grzechot/smokepowerlatch/enclosures/README.md

# Enclosures

> **Work in progress.** The enclosures here are draft versions. They will be modified,
> and more enclosures (detector module, front panel, …) will be added.
>
> *Wersje robocze – obudowy będą jeszcze zmieniane, a kolejne zostaną dodane.*

| Folder | What | Status |
|---|---|---|
| [mains_module_v4](mains_module_v4/) | 230 V module: relays K1, K2 and the 5 V standby PSU, screwed to the side of an existing printer power-switch / SSR enclosure | draft v4 (261103), not yet printed and tested |
