grzechot/smokepowerlatch/enclosures/mains_module_v4/modul_korpus.step

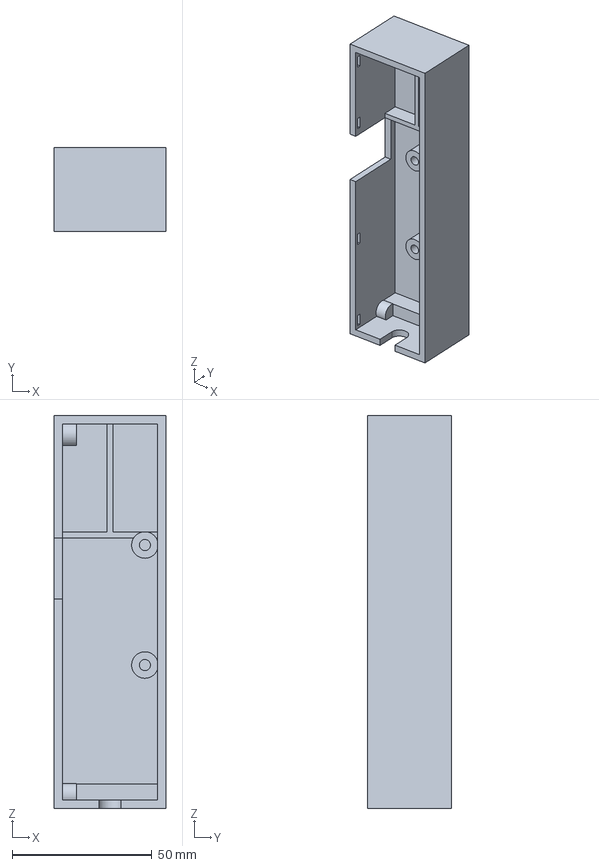
[picture p2: CAD file, 2026-11-06]
enclosures/mains_module_v4/modul_korpus.step
40.0 x 30.0 x 140.8 mm
