grzechot/smokepowerlatch/enclosures/mains_module_v4/modul_pokrywa.step

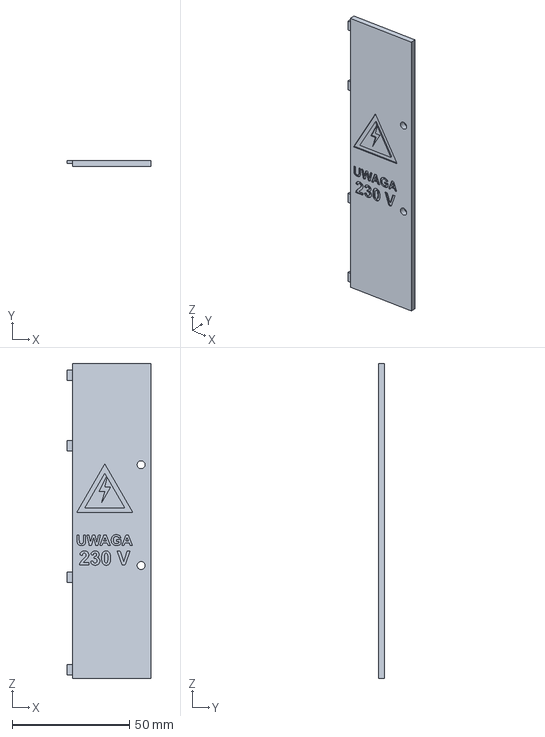
[picture p3: CAD file, 2026-11-06]
enclosures/mains_module_v4/modul_pokrywa.step
36.0 x 2.60 x 134.4 mm
