grzechot/smokepowerlatch/(list of files, cad)

Other CAD files:
enclosures/mains_module_v4/body_print.stl
enclosures/mains_module_v4/cap_print.stl
