grzechot/smokepowerlatch/kicad/printer_power_safety.kicad_sch

## KiCad design kicad/printer_power_safety.kicad_sch (2026-11-05)

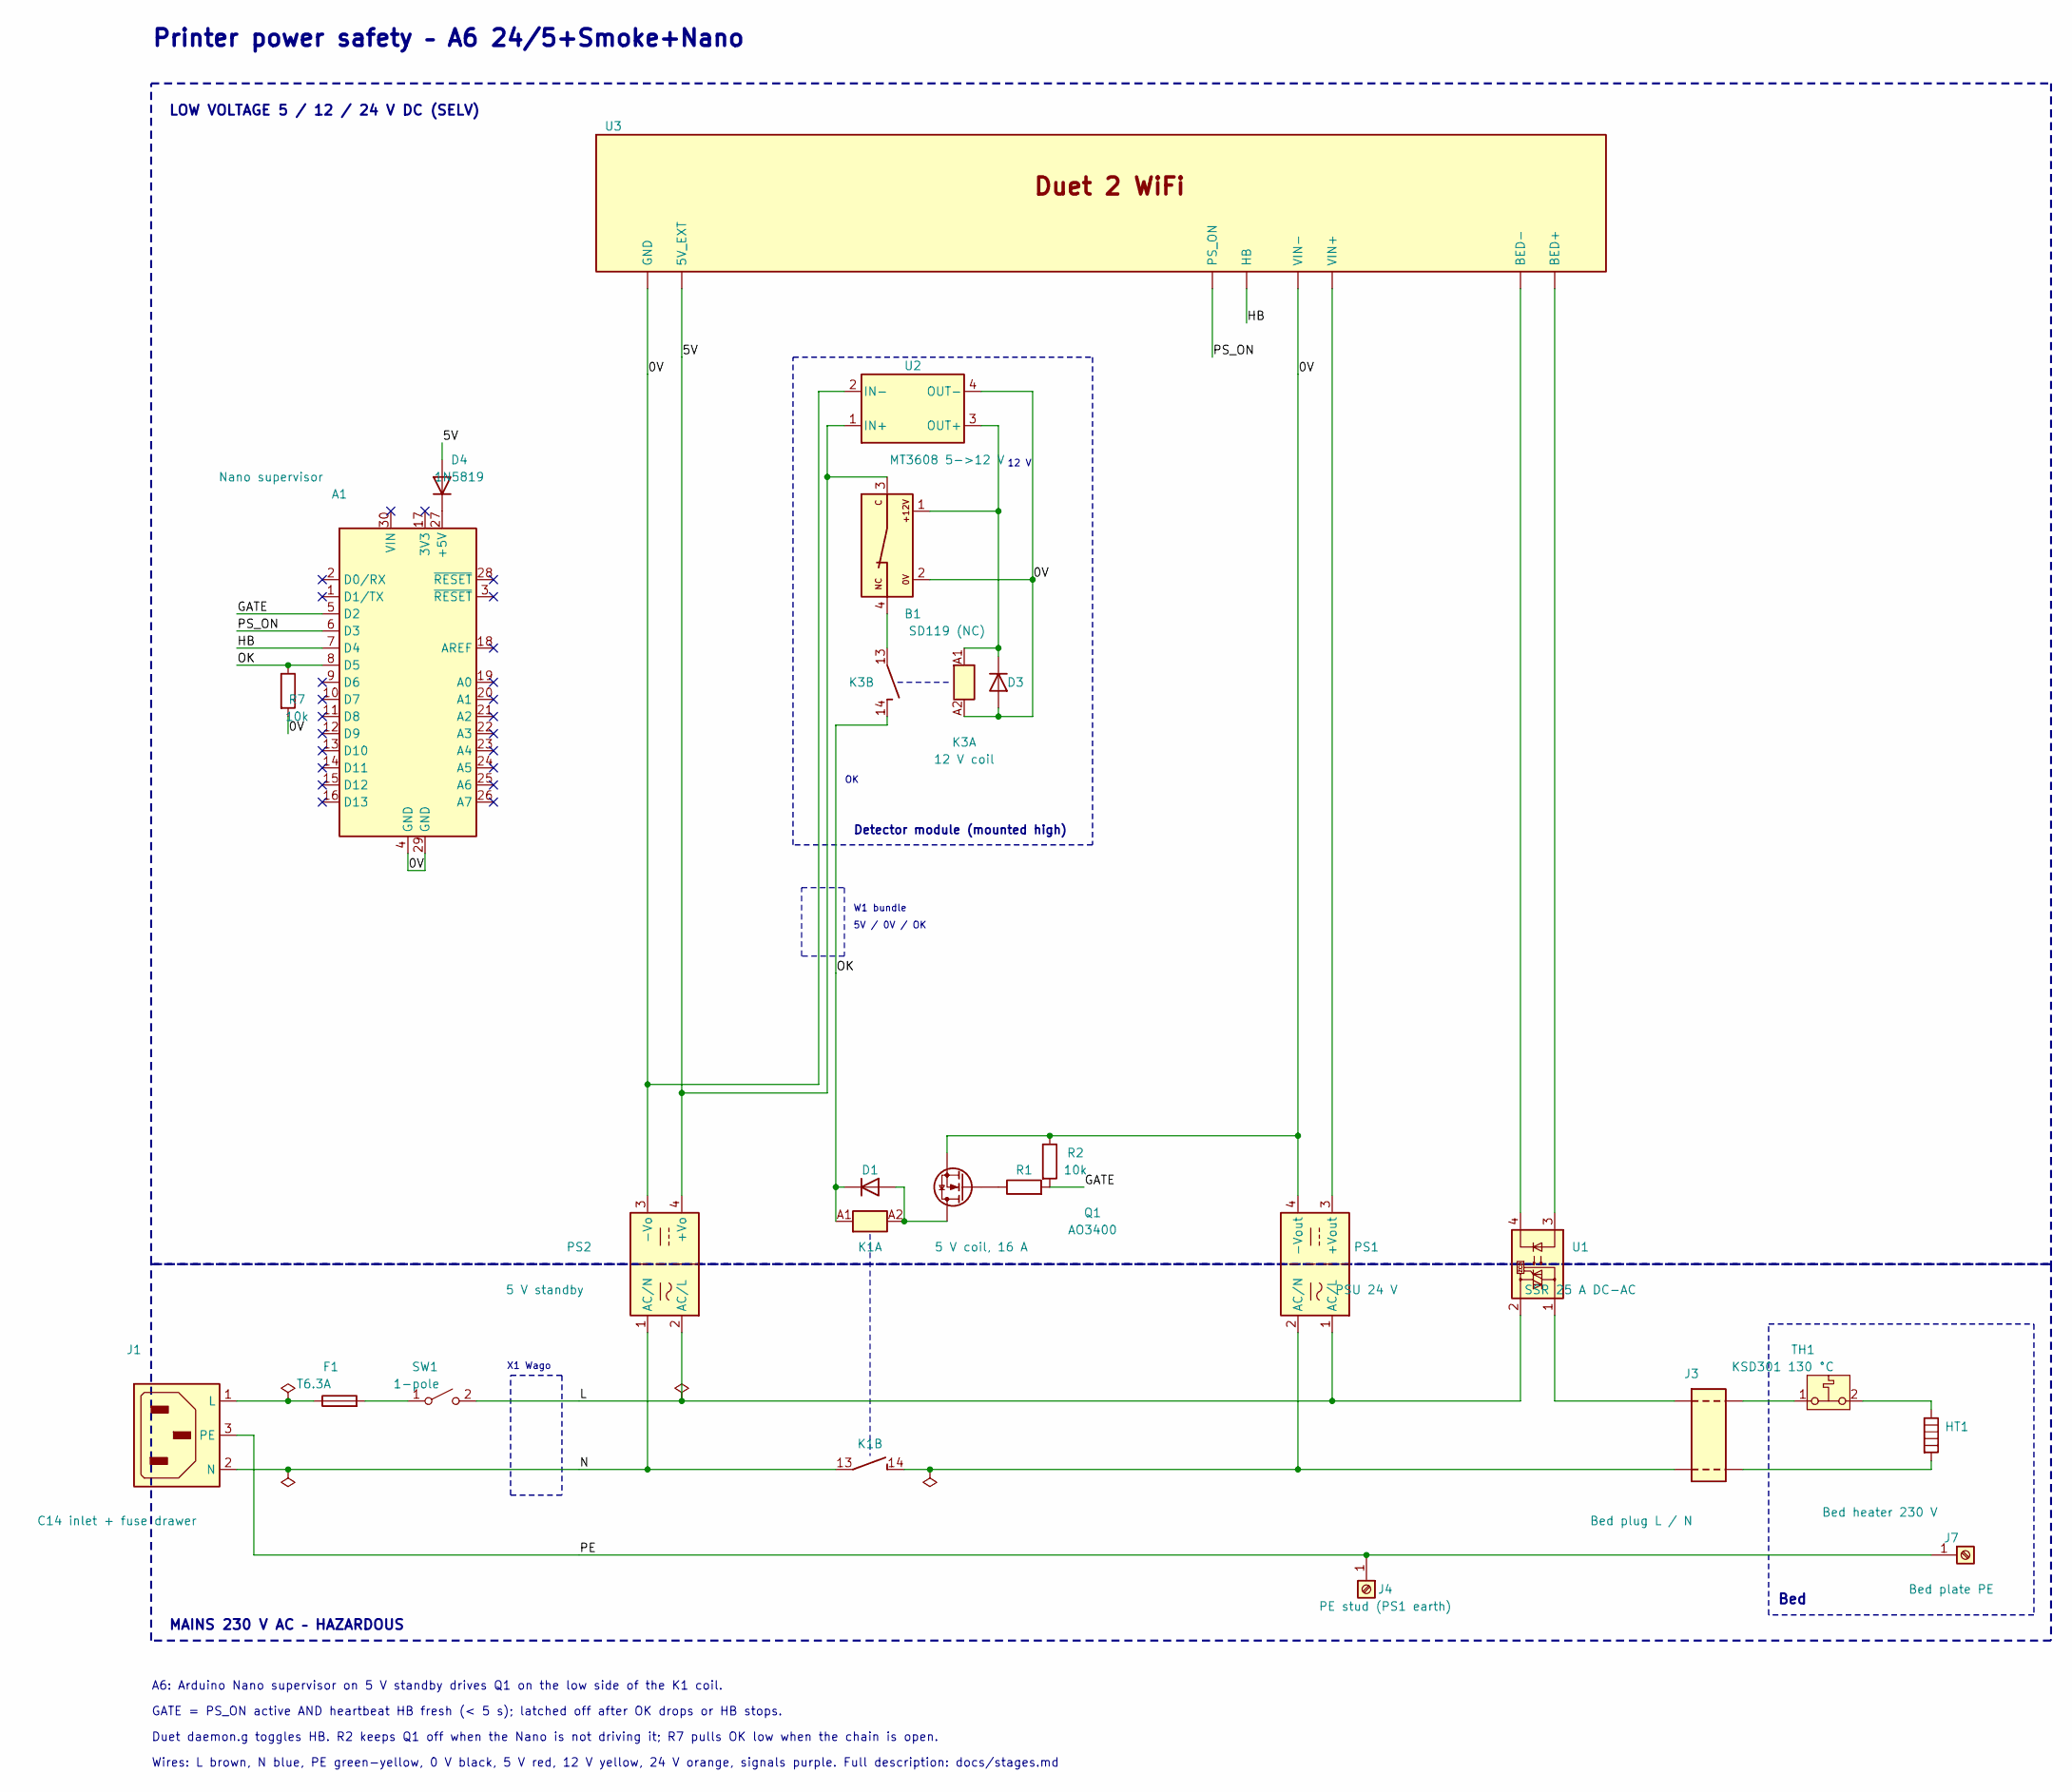
[picture p11: schematic printer_power_safety.kicad_sch]

Parts:
A1: Nano supervisor
B1: SD119 (NC)
D1, D3: 1N4148
D4: 1N5819
F1: T6.3A
HT1: Bed heater 230 V
J1: C14 inlet + fuse drawer
J3: Bed plug L / N
J4: PE stud (PS1 earth)
J7: Bed plate PE
K1, K3: (no value)
PS1: PSU 24 V
PS2: 5 V standby
Q1: AO3400
R1: 100
R2, R7: 10k
SW1: 1-pole
TH1: KSD301 130 °C
U1: SSR 25 A DC-AC
U2: MT3608 5->12 V
U3: Duet 2 WiFi

Connections:
0V: A1.4 (GND), A1.29 (GND), B1.2 (0V), D3.2 (A), K3.A2, PS1.4 (-Vout), PS2.3 (-Vo), Q1.S, R2.1, R7.2, U2.2 (IN-), U2.4 (OUT-), U3.1 (GND), U3.5 (VIN-)
5V: B1.3 (C), D4.2 (A), PS2.4 (+Vo), U2.1 (IN+), U3.2 (5V_EXT)
GATE: A1.5 (D2), R1.2, R2.2
HB: A1.7 (D4), U3.4 (HB)
L: PS1.1 (AC/L), PS2.2 (AC/L), SW1.2 (B), U1.2
N: J1.2 (N), K1.13, PS2.1 (AC/N)
unnamed: A1.27 (+5V), D4.1 (K)
unnamed: B1.1 (+12V), D3.1 (K), K3.A1, U2.3 (OUT+)
unnamed: B1.4 (NC), K3.13
unnamed: D1.2 (A), K1.A2, Q1.D
unnamed: F1.1, J1.1 (L)
unnamed: F1.2, SW1.1 (A)
unnamed: HT1.1, TH1.2
unnamed: HT1.2, J3.4 (N)
unnamed: J3.1 (L), U1.1
unnamed: J3.2 (N), K1.14, PS1.2 (AC/N)
unnamed: J3.3 (L), TH1.1
unnamed: PS1.3 (+Vout), U3.6 (VIN+)
unnamed: Q1.G, R1.1
unnamed: U1.3, U3.8 (BED+)
unnamed: U1.4, U3.7 (BED-)
OK: A1.8 (D5), D1.1 (K), K1.A1, K3.14, R7.1
PE: J1.3 (PE), J4.1, J7.1
PS_ON: A1.6 (D3), U3.3 (PS_ON)

Notes on the sheet:
X1 Wago
Bed
Detector module (mounted high)
W1 bundle
5V / 0V / OK
12 V
LOW VOLTAGE 5 / 12 / 24 V DC (SELV)
MAINS 230 V AC – HAZARDOUS
Printer power safety – A6 24/5+Smoke+Nano
A6: Arduino Nano supervisor on 5 V standby drives Q1 on the low side of the K1 coil.
GATE = PS_ON active AND heartbeat HB fresh (< 5 s); latched off after OK drops or HB stops.
Duet daemon.g toggles HB. R2 keeps Q1 off when the Nano is not driving it; R7 pulls OK low when the chain is open.
Wires: L brown, N blue, PE green-yellow, 0 V black, 5 V red, 12 V yellow, 24 V orange, signals purple. Full description: docs/stages.md
