grzechot/smokepowerlatch/kicad/steps/A0_firestarter.kicad_sch

## KiCad design kicad/steps/A0_firestarter.kicad_sch (2026-11-05)

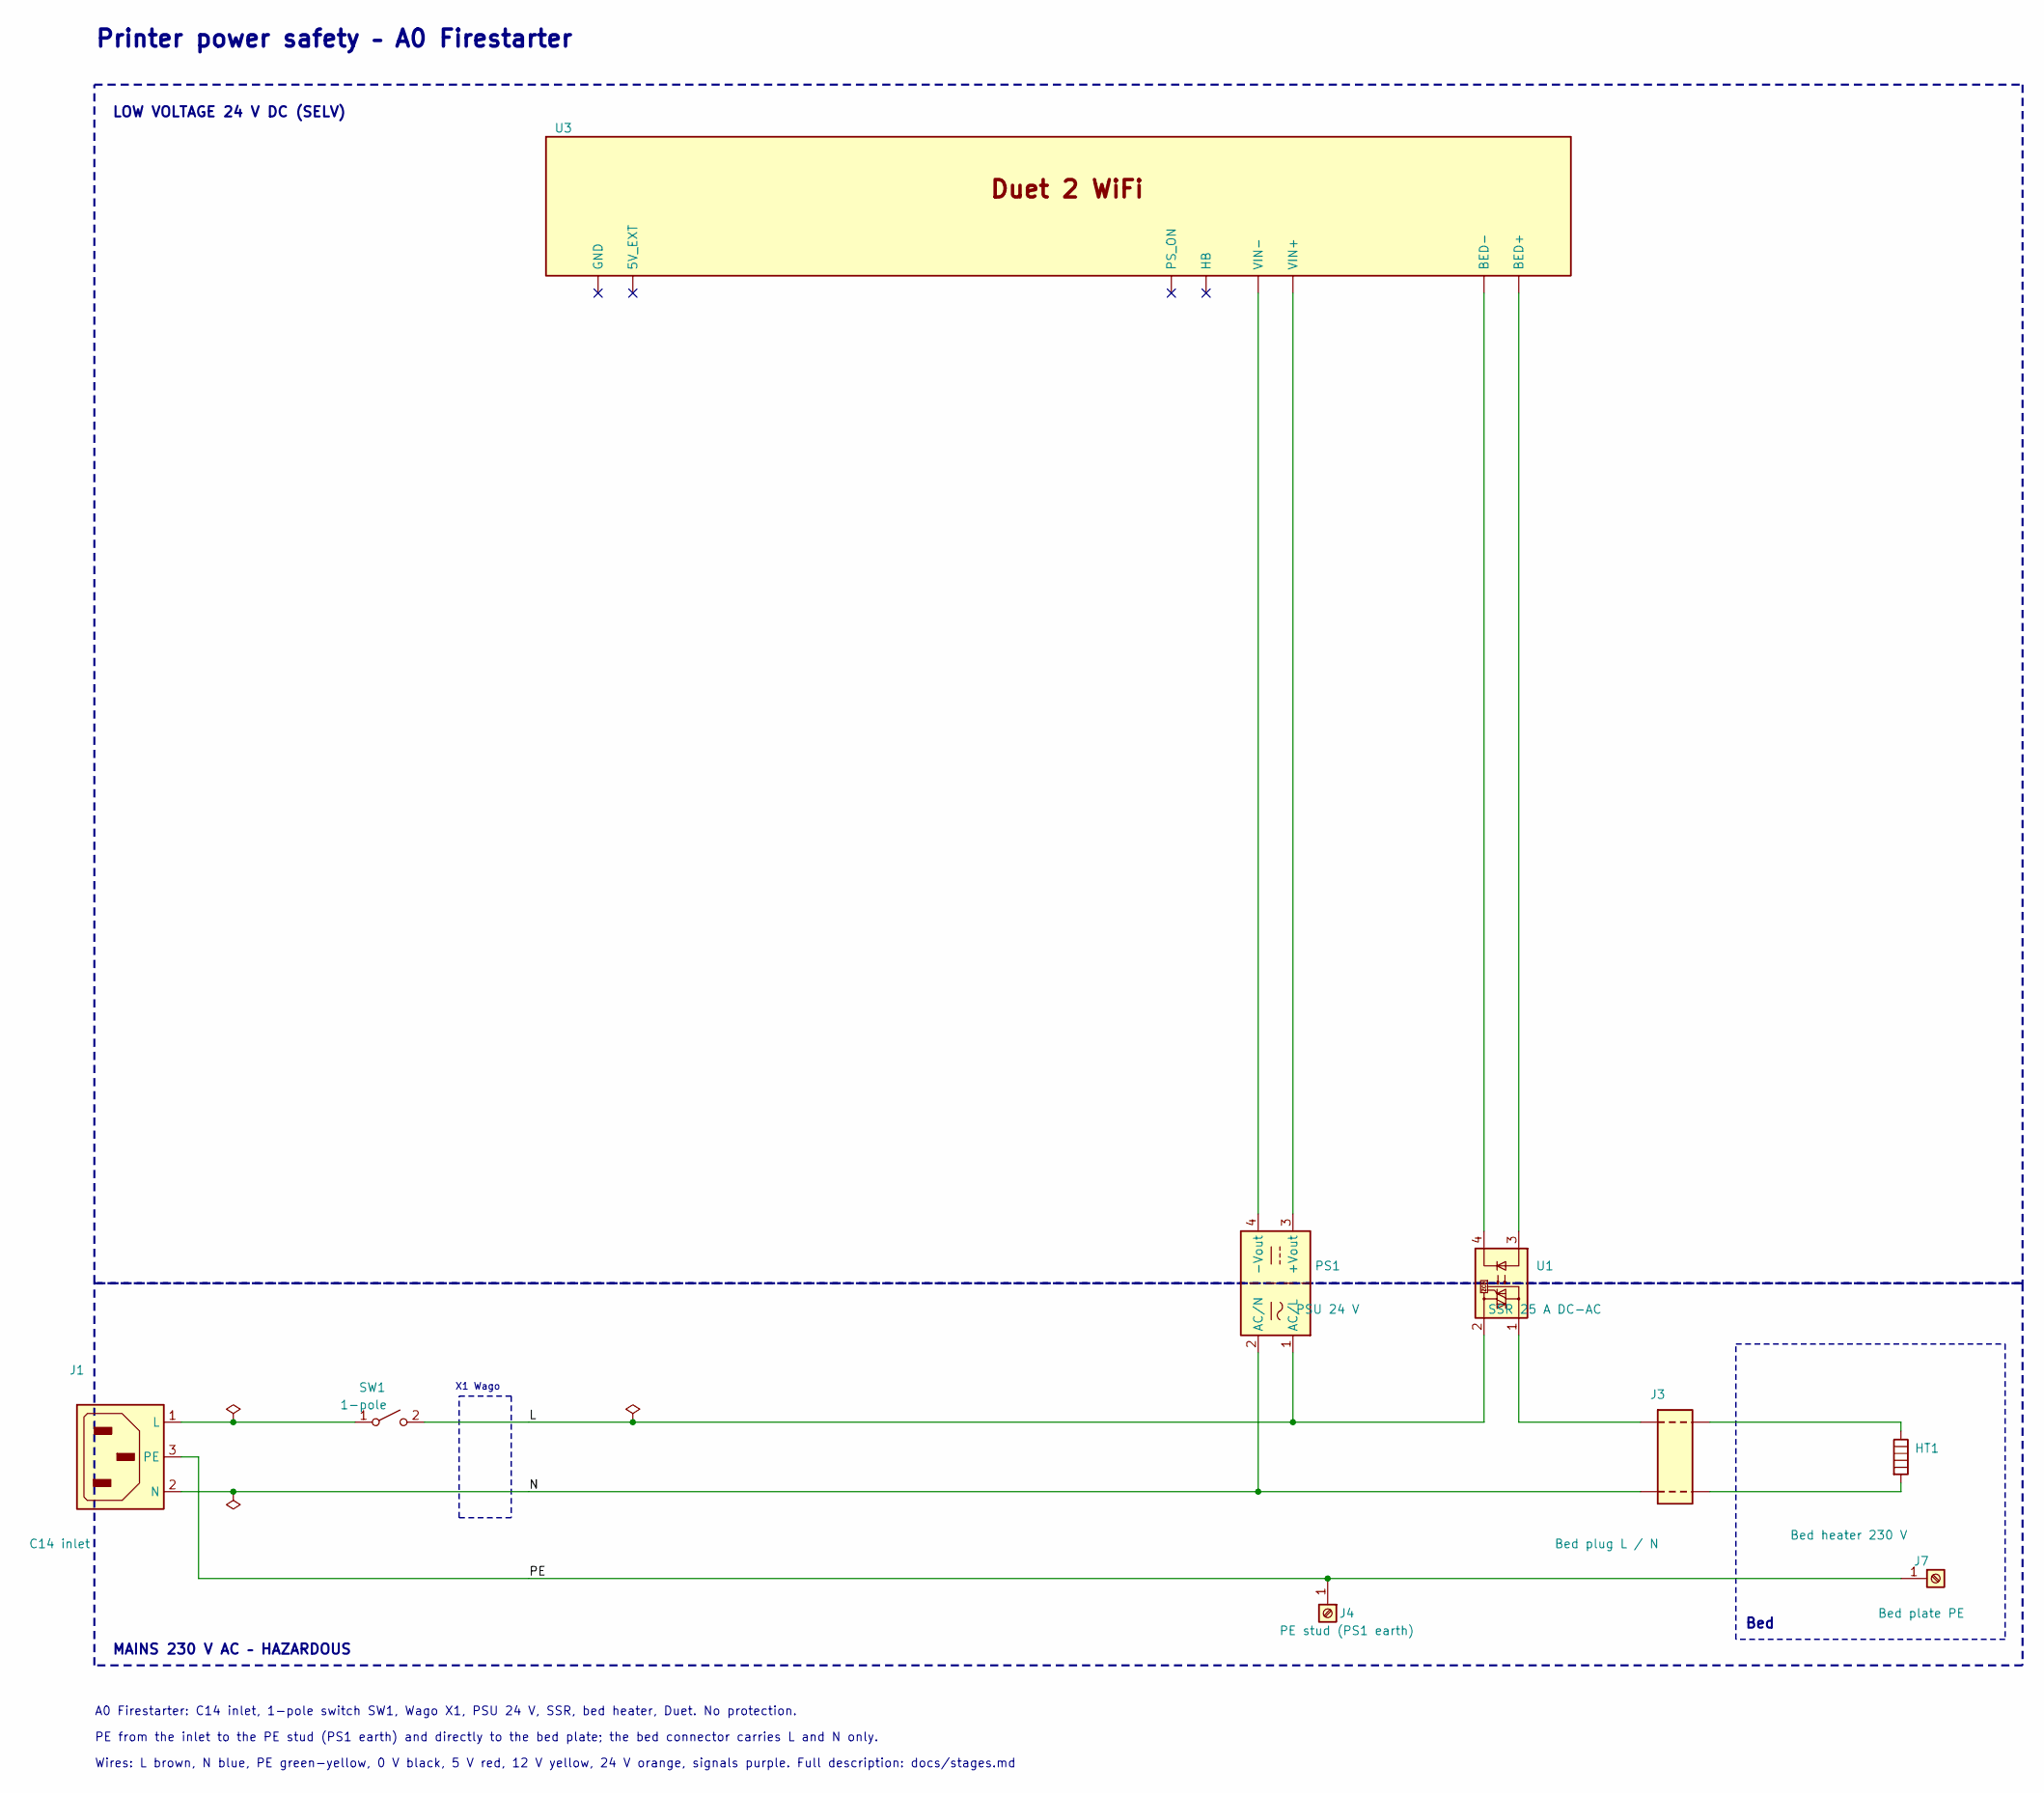
[picture p12: schematic A0_firestarter.kicad_sch]

Parts:
HT1: Bed heater 230 V
J1: C14 inlet
J3: Bed plug L / N
J4: PE stud (PS1 earth)
J7: Bed plate PE
PS1: PSU 24 V
SW1: 1-pole
U1: SSR 25 A DC-AC
U3: Duet 2 WiFi

Connections:
L: PS1.1 (AC/L), SW1.2 (B), U1.2
N: J1.2 (N), J3.2 (N), PS1.2 (AC/N)
unnamed: HT1.1, J3.3 (L)
unnamed: HT1.2, J3.4 (N)
unnamed: J1.1 (L), SW1.1 (A)
unnamed: J3.1 (L), U1.1
unnamed: PS1.3 (+Vout), U3.6 (VIN+)
unnamed: PS1.4 (-Vout), U3.5 (VIN-)
unnamed: U1.3, U3.8 (BED+)
unnamed: U1.4, U3.7 (BED-)
PE: J1.3 (PE), J4.1, J7.1

Notes on the sheet:
X1 Wago
Bed
LOW VOLTAGE 24 V DC (SELV)
MAINS 230 V AC – HAZARDOUS
Printer power safety – A0 Firestarter
A0 Firestarter: C14 inlet, 1-pole switch SW1, Wago X1, PSU 24 V, SSR, bed heater, Duet. No protection.
PE from the inlet to the PE stud (PS1 earth) and directly to the bed plate; the bed connector carries L and N only.
Wires: L brown, N blue, PE green-yellow, 0 V black, 5 V red, 12 V yellow, 24 V orange, signals purple. Full description: docs/stages.md
