grzechot/smokepowerlatch/kicad/steps/A2_24_thermalcut_fuse.kicad_sch

## KiCad design kicad/steps/A2_24_thermalcut_fuse.kicad_sch (2026-11-05)

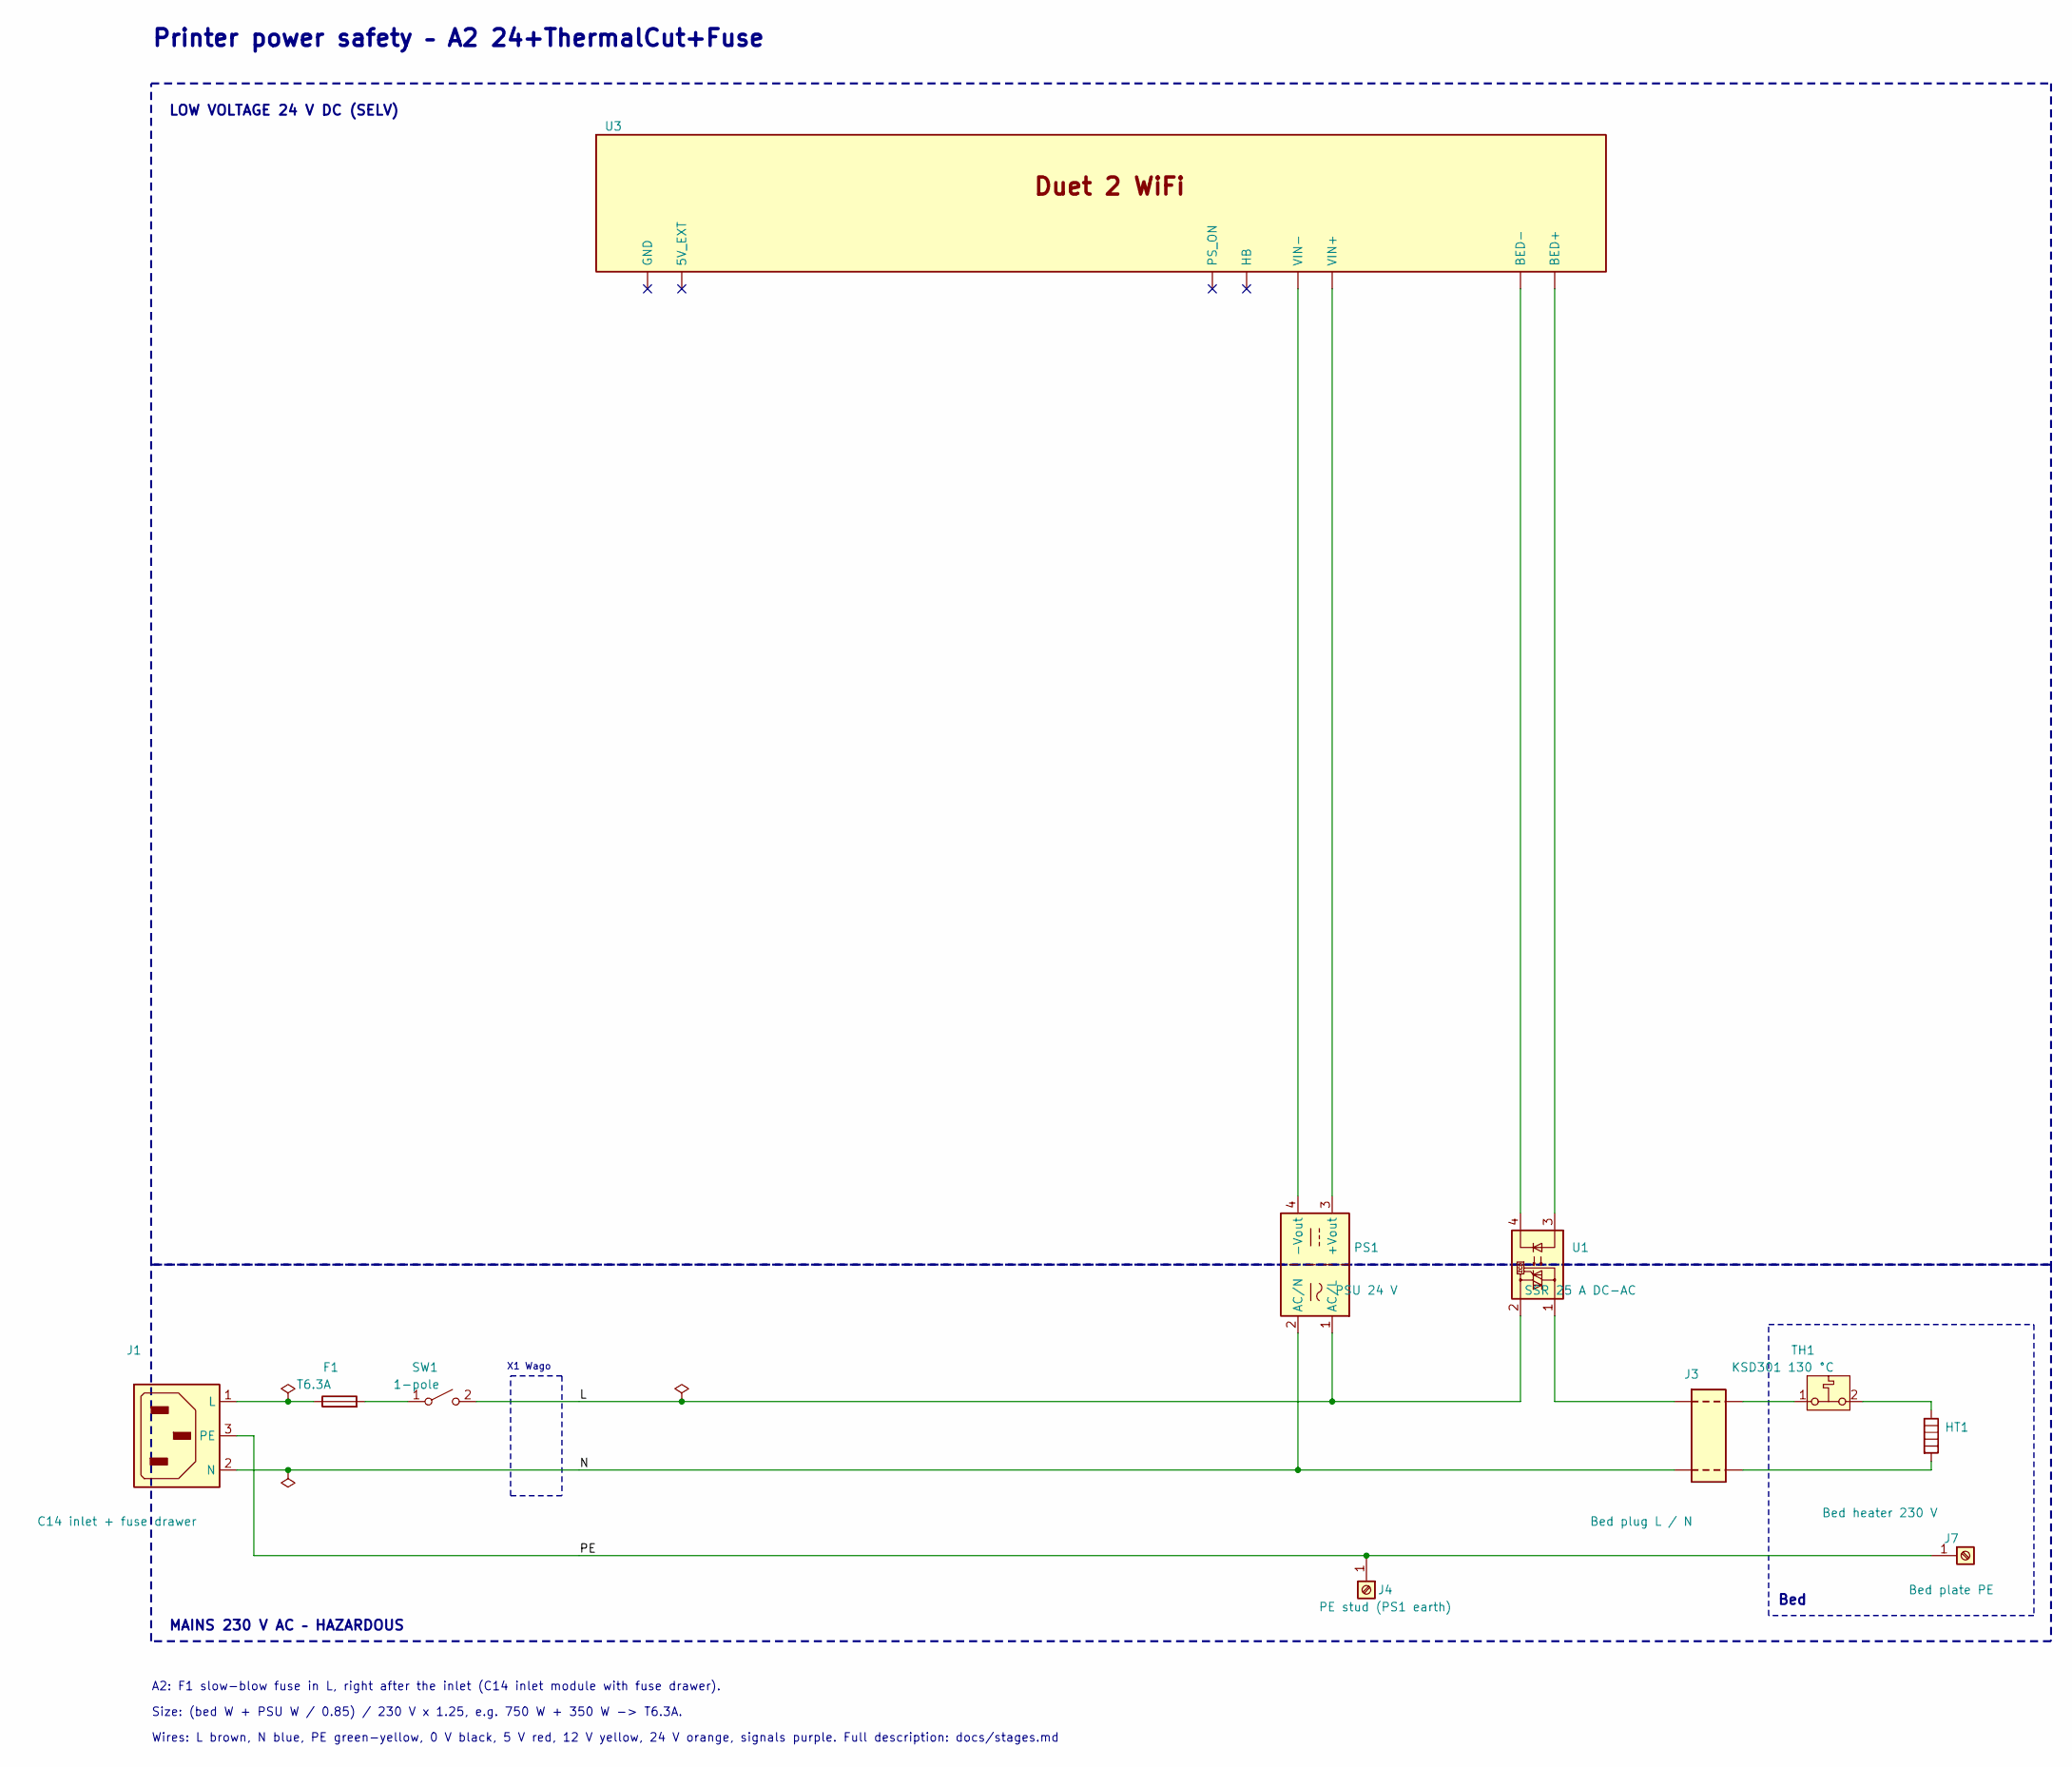
[picture p13: schematic A2_24_thermalcut_fuse.kicad_sch]

Parts:
F1: T6.3A
HT1: Bed heater 230 V
J1: C14 inlet + fuse drawer
J3: Bed plug L / N
J4: PE stud (PS1 earth)
J7: Bed plate PE
PS1: PSU 24 V
SW1: 1-pole
TH1: KSD301 130 °C
U1: SSR 25 A DC-AC
U3: Duet 2 WiFi

Connections:
L: PS1.1 (AC/L), SW1.2 (B), U1.2
N: J1.2 (N), J3.2 (N), PS1.2 (AC/N)
unnamed: F1.1, J1.1 (L)
unnamed: F1.2, SW1.1 (A)
unnamed: HT1.1, TH1.2
unnamed: HT1.2, J3.4 (N)
unnamed: J3.1 (L), U1.1
unnamed: J3.3 (L), TH1.1
unnamed: PS1.3 (+Vout), U3.6 (VIN+)
unnamed: PS1.4 (-Vout), U3.5 (VIN-)
unnamed: U1.3, U3.8 (BED+)
unnamed: U1.4, U3.7 (BED-)
PE: J1.3 (PE), J4.1, J7.1

Notes on the sheet:
X1 Wago
Bed
LOW VOLTAGE 24 V DC (SELV)
MAINS 230 V AC – HAZARDOUS
Printer power safety – A2 24+ThermalCut+Fuse
A2: F1 slow-blow fuse in L, right after the inlet (C14 inlet module with fuse drawer).
Size: (bed W + PSU W / 0.85) / 230 V x 1.25, e.g. 750 W + 350 W -> T6.3A.
Wires: L brown, N blue, PE green-yellow, 0 V black, 5 V red, 12 V yellow, 24 V orange, signals purple. Full description: docs/stages.md
