grzechot/smokepowerlatch/kicad/steps/A3_24_relay.kicad_sch

## KiCad design kicad/steps/A3_24_relay.kicad_sch (2026-11-05)

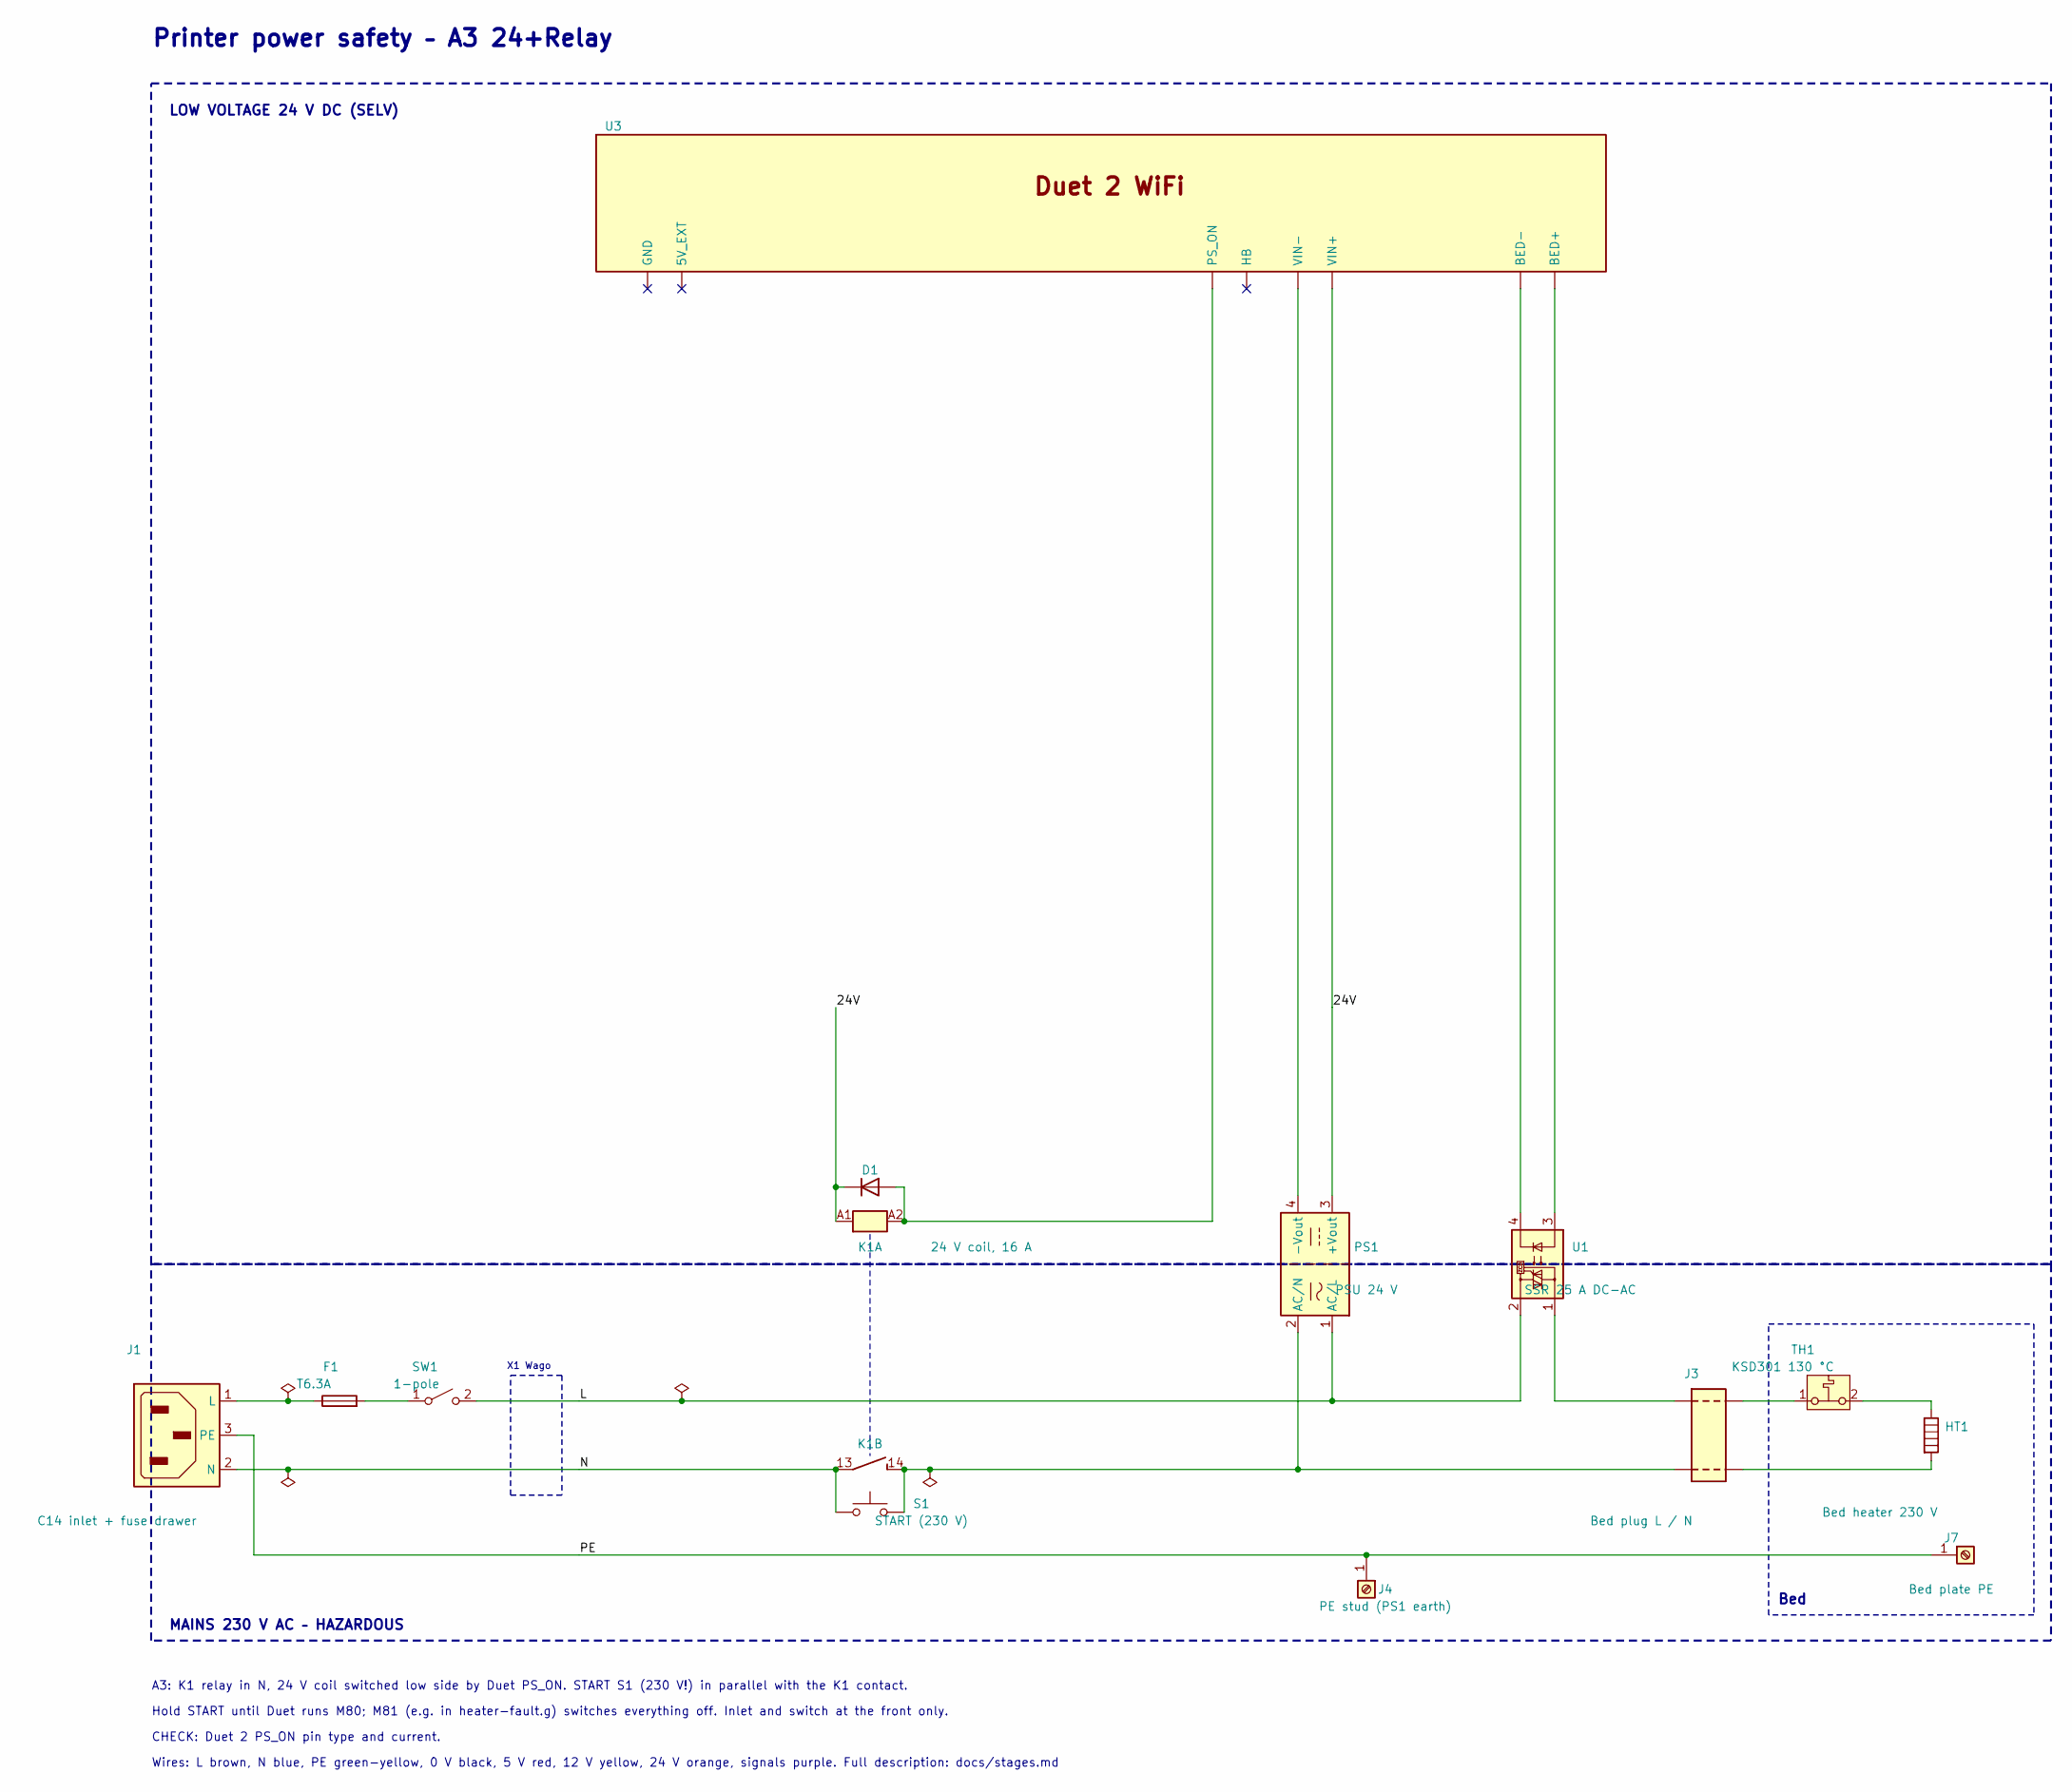
[picture p14: schematic A3_24_relay.kicad_sch]

Parts:
D1: 1N4148
F1: T6.3A
HT1: Bed heater 230 V
J1: C14 inlet + fuse drawer
J3: Bed plug L / N
J4: PE stud (PS1 earth)
J7: Bed plate PE
K1: (no value)
PS1: PSU 24 V
S1: START (230 V)
SW1: 1-pole
TH1: KSD301 130 °C
U1: SSR 25 A DC-AC
U3: Duet 2 WiFi

Connections:
24V: D1.1 (K), K1.A1, PS1.3 (+Vout), U3.6 (VIN+)
L: PS1.1 (AC/L), SW1.2 (B), U1.2
N: J1.2 (N), K1.13, S1.1
unnamed: D1.2 (A), K1.A2, U3.3 (PS_ON)
unnamed: F1.1, J1.1 (L)
unnamed: F1.2, SW1.1 (A)
unnamed: HT1.1, TH1.2
unnamed: HT1.2, J3.4 (N)
unnamed: J3.1 (L), U1.1
unnamed: J3.2 (N), K1.14, PS1.2 (AC/N), S1.2
unnamed: J3.3 (L), TH1.1
unnamed: PS1.4 (-Vout), U3.5 (VIN-)
unnamed: U1.3, U3.8 (BED+)
unnamed: U1.4, U3.7 (BED-)
PE: J1.3 (PE), J4.1, J7.1

Notes on the sheet:
X1 Wago
Bed
LOW VOLTAGE 24 V DC (SELV)
MAINS 230 V AC – HAZARDOUS
Printer power safety – A3 24+Relay
A3: K1 relay in N, 24 V coil switched low side by Duet PS_ON. START S1 (230 V!) in parallel with the K1 contact.
Hold START until Duet runs M80; M81 (e.g. in heater-fault.g) switches everything off. Inlet and switch at the front only.
CHECK: Duet 2 PS_ON pin type and current.
Wires: L brown, N blue, PE green-yellow, 0 V black, 5 V red, 12 V yellow, 24 V orange, signals purple. Full description: docs/stages.md
