grzechot/smokepowerlatch/kicad/steps/A5_24-5_smoke.kicad_sch

## KiCad design kicad/steps/A5_24-5_smoke.kicad_sch (2026-11-05)

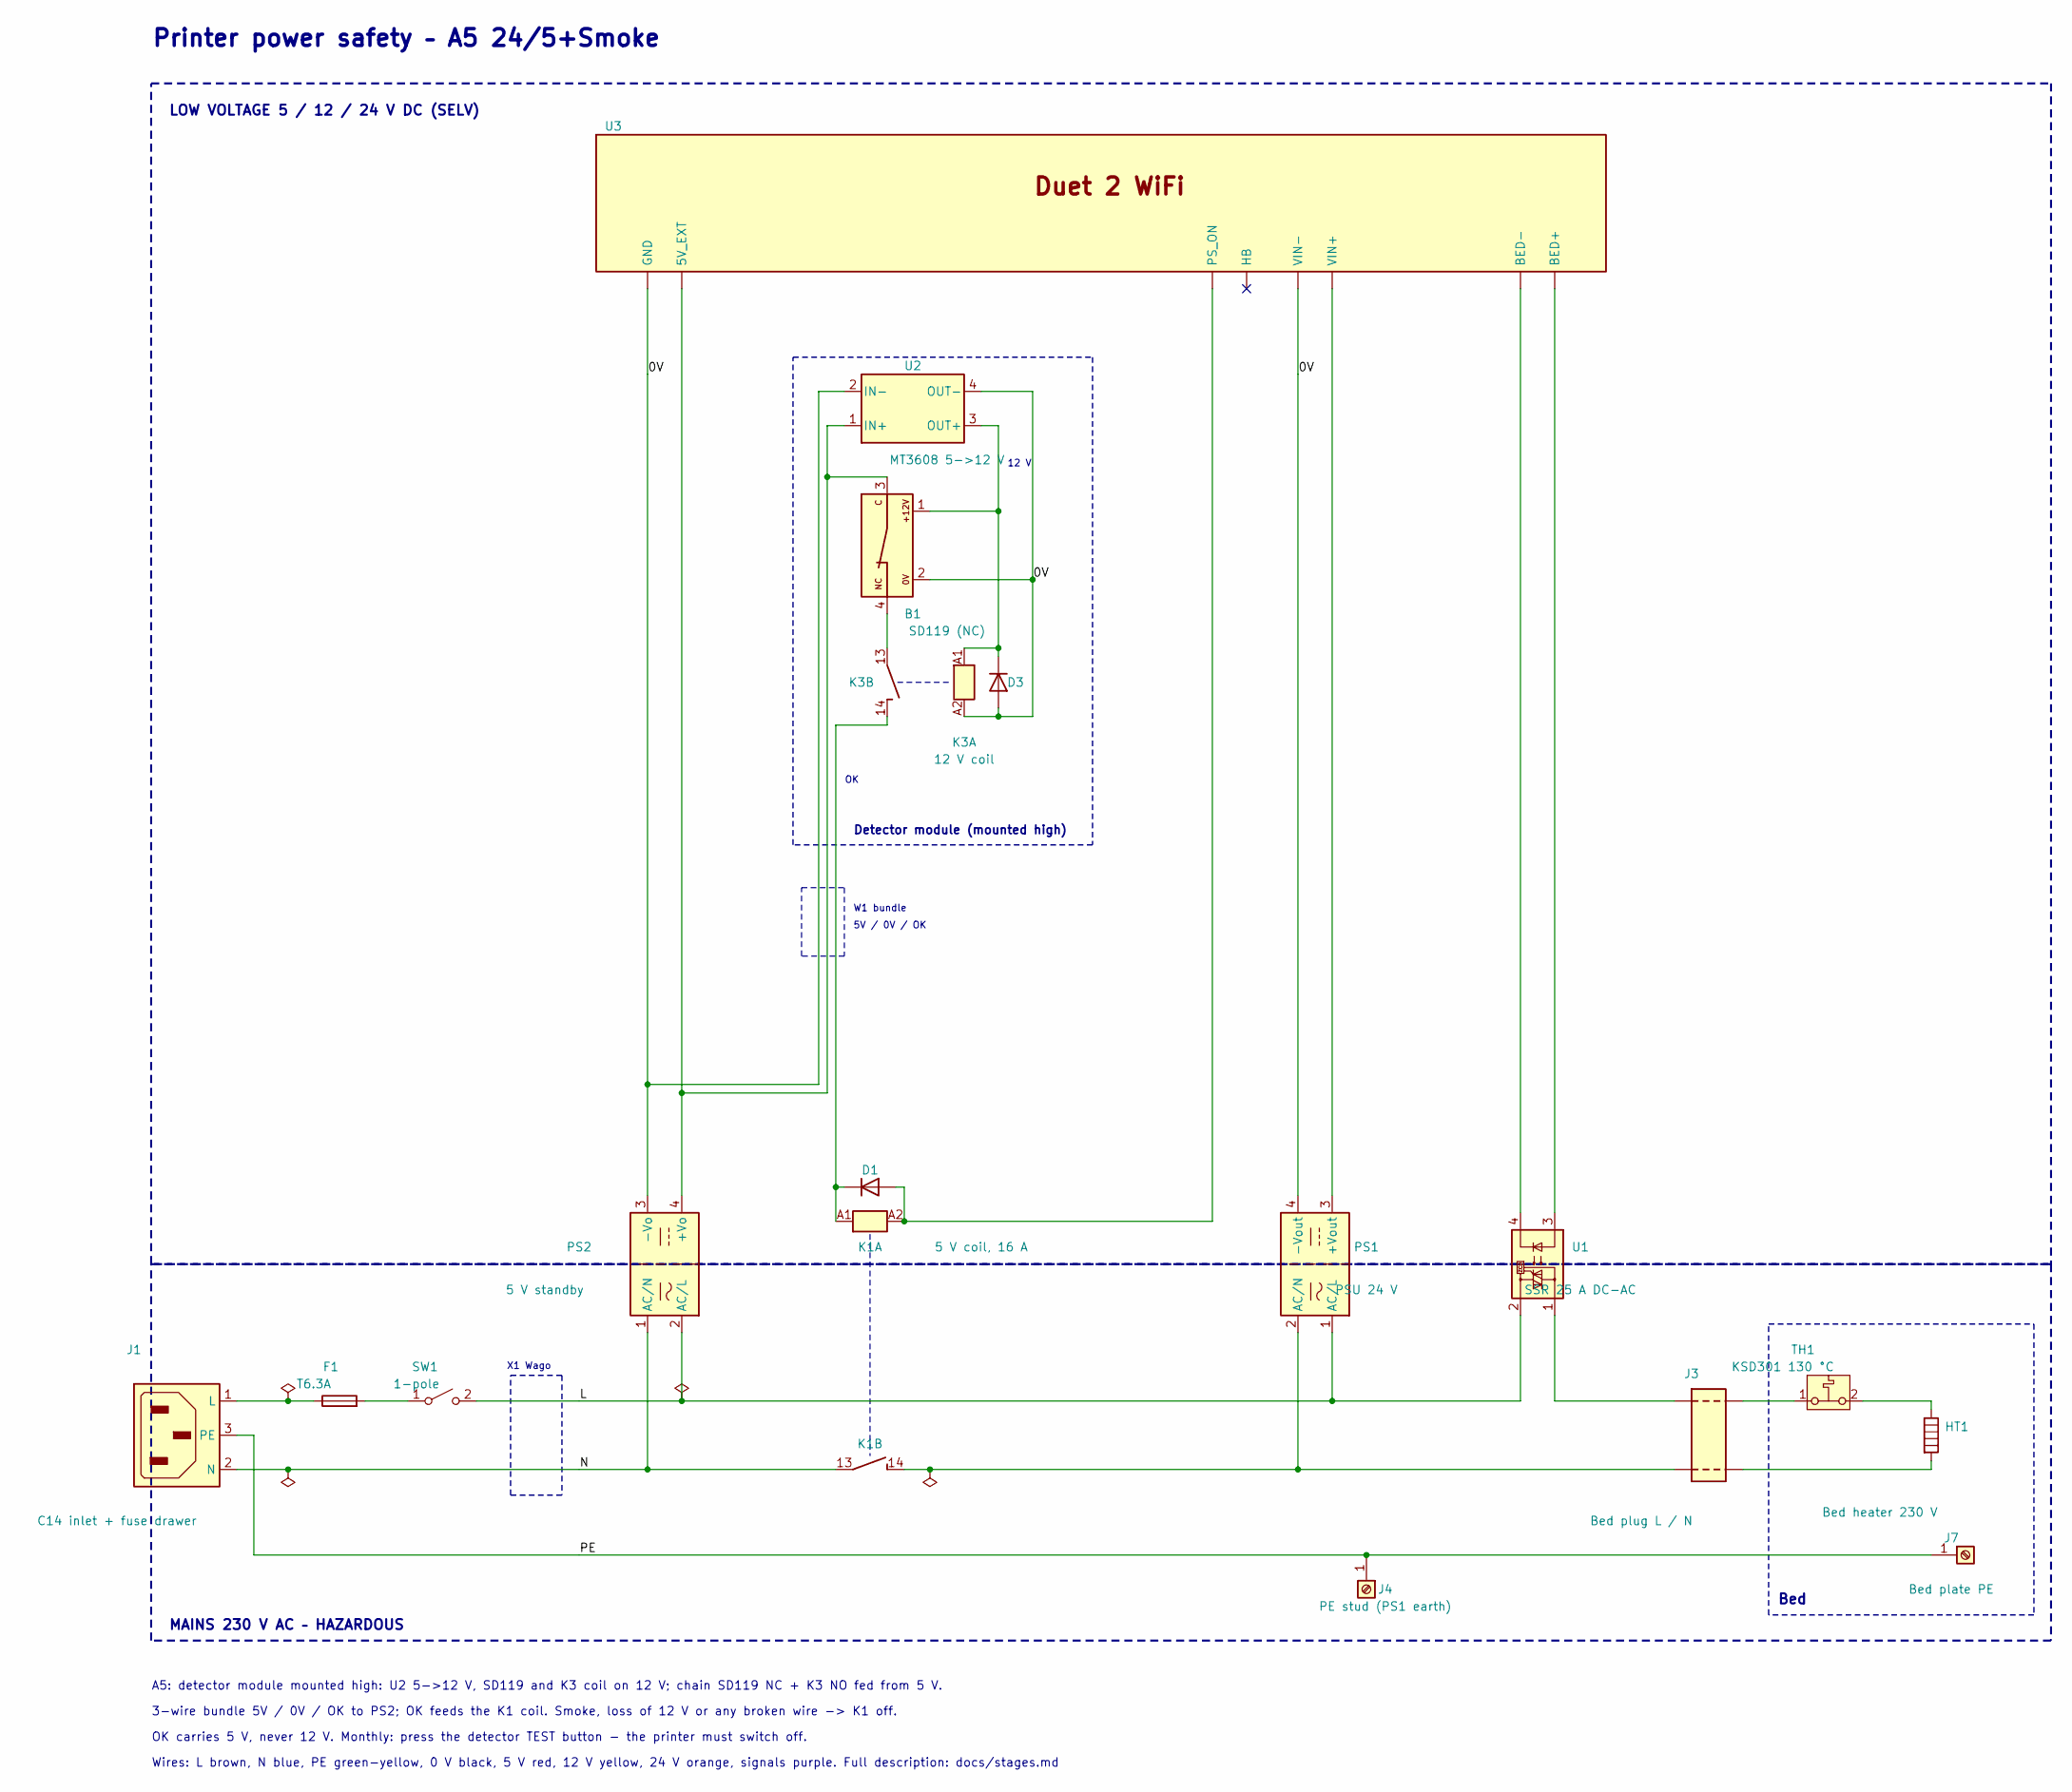
[picture p15: schematic A5_24-5_smoke.kicad_sch]

Parts:
B1: SD119 (NC)
D1, D3: 1N4148
F1: T6.3A
HT1: Bed heater 230 V
J1: C14 inlet + fuse drawer
J3: Bed plug L / N
J4: PE stud (PS1 earth)
J7: Bed plate PE
K1, K3: (no value)
PS1: PSU 24 V
PS2: 5 V standby
SW1: 1-pole
TH1: KSD301 130 °C
U1: SSR 25 A DC-AC
U2: MT3608 5->12 V
U3: Duet 2 WiFi

Connections:
0V: B1.2 (0V), D3.2 (A), K3.A2, PS1.4 (-Vout), PS2.3 (-Vo), U2.2 (IN-), U2.4 (OUT-), U3.1 (GND), U3.5 (VIN-)
L: PS1.1 (AC/L), PS2.2 (AC/L), SW1.2 (B), U1.2
N: J1.2 (N), K1.13, PS2.1 (AC/N)
unnamed: B1.1 (+12V), D3.1 (K), K3.A1, U2.3 (OUT+)
unnamed: B1.3 (C), PS2.4 (+Vo), U2.1 (IN+), U3.2 (5V_EXT)
unnamed: B1.4 (NC), K3.13
unnamed: D1.1 (K), K1.A1, K3.14
unnamed: D1.2 (A), K1.A2, U3.3 (PS_ON)
unnamed: F1.1, J1.1 (L)
unnamed: F1.2, SW1.1 (A)
unnamed: HT1.1, TH1.2
unnamed: HT1.2, J3.4 (N)
unnamed: J3.1 (L), U1.1
unnamed: J3.2 (N), K1.14, PS1.2 (AC/N)
unnamed: J3.3 (L), TH1.1
unnamed: PS1.3 (+Vout), U3.6 (VIN+)
unnamed: U1.3, U3.8 (BED+)
unnamed: U1.4, U3.7 (BED-)
PE: J1.3 (PE), J4.1, J7.1

Notes on the sheet:
X1 Wago
Bed
Detector module (mounted high)
W1 bundle
5V / 0V / OK
12 V
LOW VOLTAGE 5 / 12 / 24 V DC (SELV)
MAINS 230 V AC – HAZARDOUS
Printer power safety – A5 24/5+Smoke
A5: detector module mounted high: U2 5->12 V, SD119 and K3 coil on 12 V; chain SD119 NC + K3 NO fed from 5 V.
3-wire bundle 5V / 0V / OK to PS2; OK feeds the K1 coil. Smoke, loss of 12 V or any broken wire -> K1 off.
OK carries 5 V, never 12 V. Monthly: press the detector TEST button - the printer must switch off.
Wires: L brown, N blue, PE green-yellow, 0 V black, 5 V red, 12 V yellow, 24 V orange, signals purple. Full description: docs/stages.md
