grzechot/smokepowerlatch/kicad/steps/step0_baseline.kicad_sch

## KiCad design kicad/steps/step0_baseline.kicad_sch (2026-11-04)

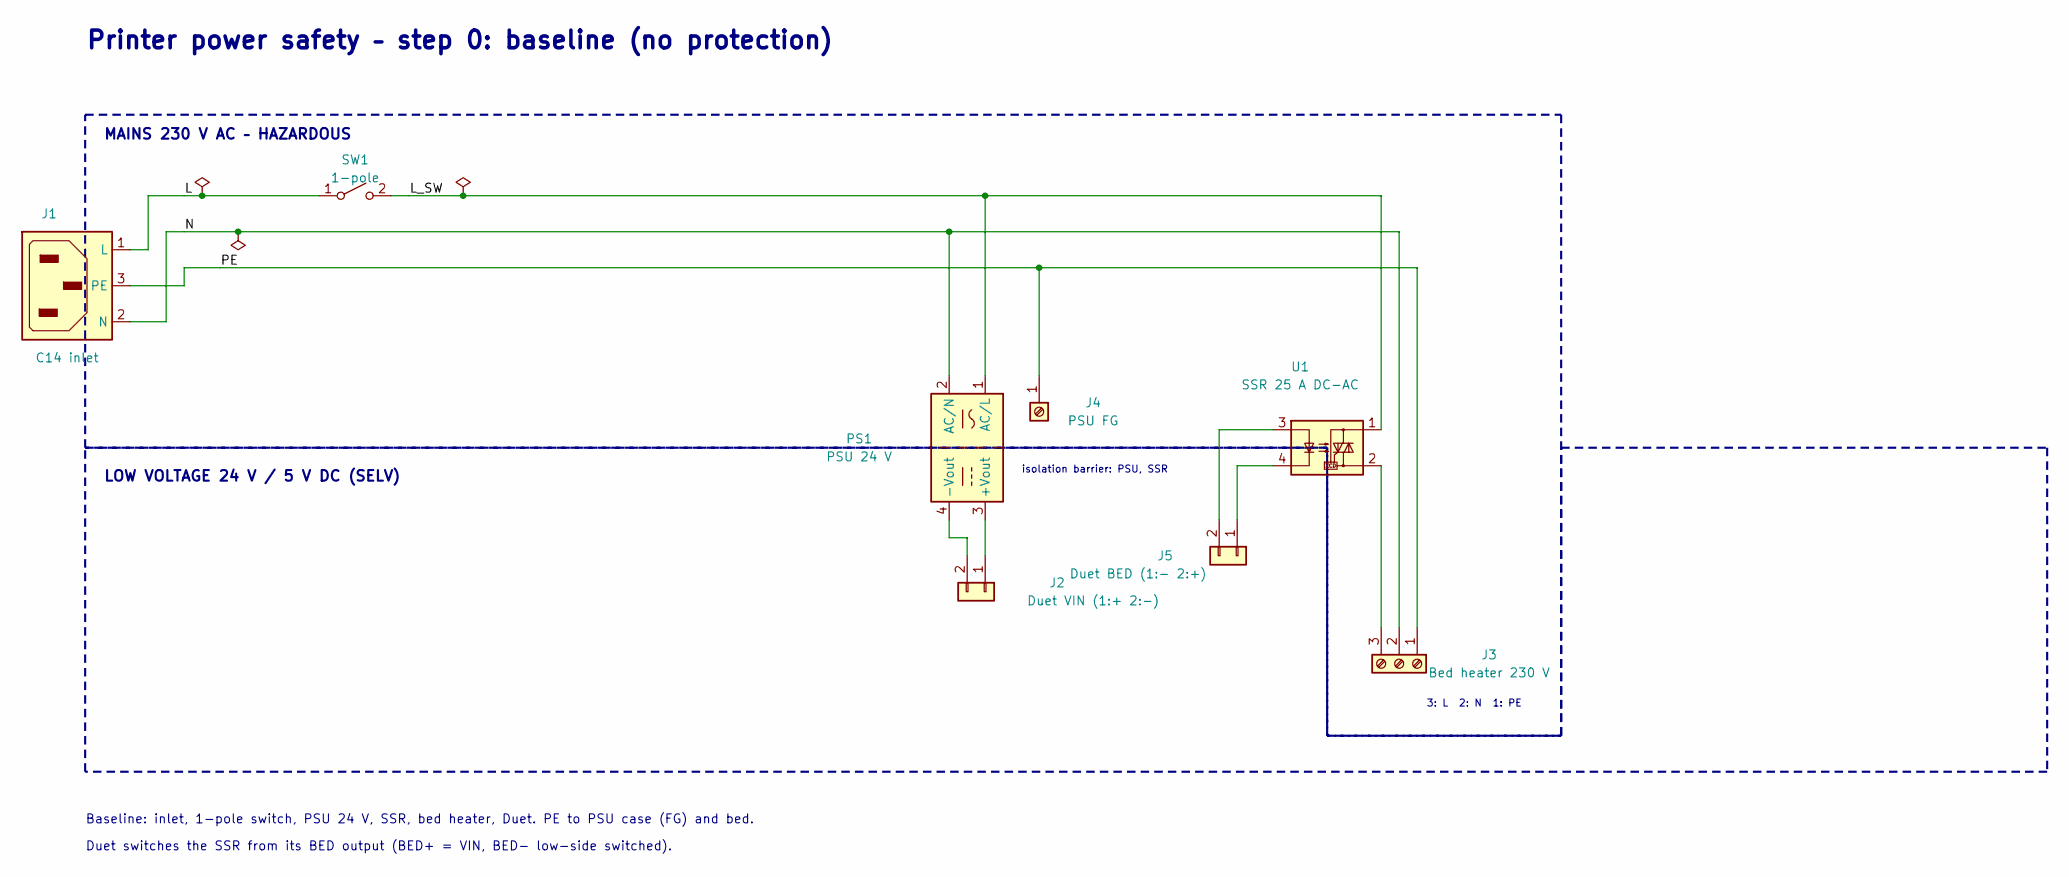
[picture p16: schematic step0_baseline.kicad_sch]

Parts:
J1: C14 inlet
J2: Duet VIN (1:+ 2:-)
J3: Bed heater 230 V
J4: PSU FG
J5: Duet BED (1:- 2:+)
PS1: PSU 24 V
SW1: 1-pole
U1: SSR 25 A DC-AC

Connections:
L: J1.1 (L), SW1.1 (A)
L_SW: PS1.1 (AC/L), SW1.2 (B), U1.1
N: J1.2 (N), J3.2, PS1.2 (AC/N)
unnamed: J2.1, PS1.3 (+Vout)
unnamed: J2.2, PS1.4 (-Vout)
unnamed: J3.3, U1.2
unnamed: J5.1, U1.4
unnamed: J5.2, U1.3
PE: J1.3 (PE), J3.1, J4.1

Notes on the sheet:
3: L 2: N 1: PE
MAINS 230 V AC – HAZARDOUS
LOW VOLTAGE 24 V / 5 V DC (SELV)
isolation barrier: PSU, SSR
Printer power safety – step 0: baseline (no protection)
Baseline: inlet, 1-pole switch, PSU 24 V, SSR, bed heater, Duet. PE to PSU case (FG) and bed.
Duet switches the SSR from its BED output (BED+ = VIN, BED- low-side switched).
