grzechot/smokepowerlatch/kicad/steps/step3_two_pole_switch.kicad_sch

## KiCad design kicad/steps/step3_two_pole_switch.kicad_sch (2026-11-04)

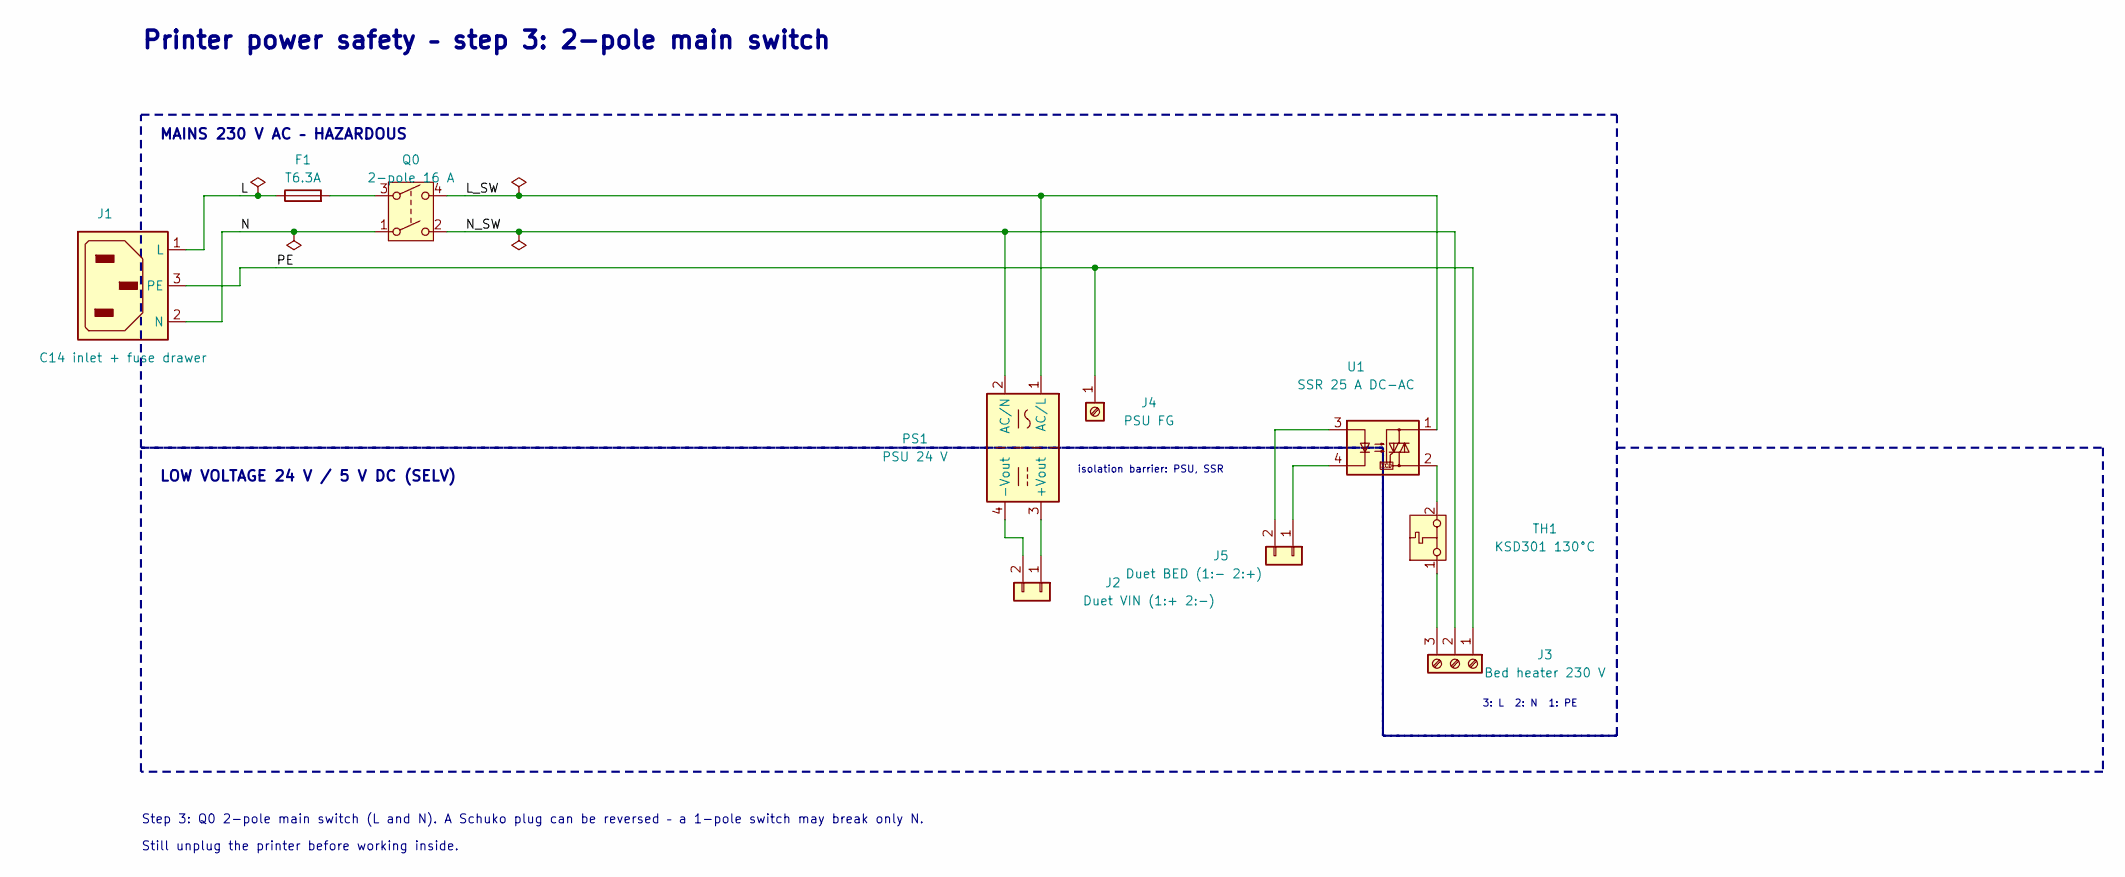
[picture p17: schematic step3_two_pole_switch.kicad_sch]

Parts:
F1: T6.3A
J1: C14 inlet + fuse drawer
J2: Duet VIN (1:+ 2:-)
J3: Bed heater 230 V
J4: PSU FG
J5: Duet BED (1:- 2:+)
PS1: PSU 24 V
Q0: 2-pole 16 A
TH1: KSD301 130°C
U1: SSR 25 A DC-AC

Connections:
L: F1.1, J1.1 (L)
L_SW: PS1.1 (AC/L), Q0.4, U1.1
N: J1.2 (N), Q0.1
N_SW: J3.2, PS1.2 (AC/N), Q0.2
unnamed: F1.2, Q0.3
unnamed: J2.1, PS1.3 (+Vout)
unnamed: J2.2, PS1.4 (-Vout)
unnamed: J3.3, TH1.1
unnamed: J5.1, U1.4
unnamed: J5.2, U1.3
unnamed: TH1.2, U1.2
PE: J1.3 (PE), J3.1, J4.1

Notes on the sheet:
3: L 2: N 1: PE
MAINS 230 V AC – HAZARDOUS
LOW VOLTAGE 24 V / 5 V DC (SELV)
isolation barrier: PSU, SSR
Printer power safety – step 3: 2-pole main switch
Step 3: Q0 2-pole main switch (L and N). A Schuko plug can be reversed – a 1-pole switch may break only N.
Still unplug the printer before working inside.
