grzechot/smokepowerlatch/kicad/steps/step4_mains_relays_stop.kicad_sch

## KiCad design kicad/steps/step4_mains_relays_stop.kicad_sch (2026-11-04)

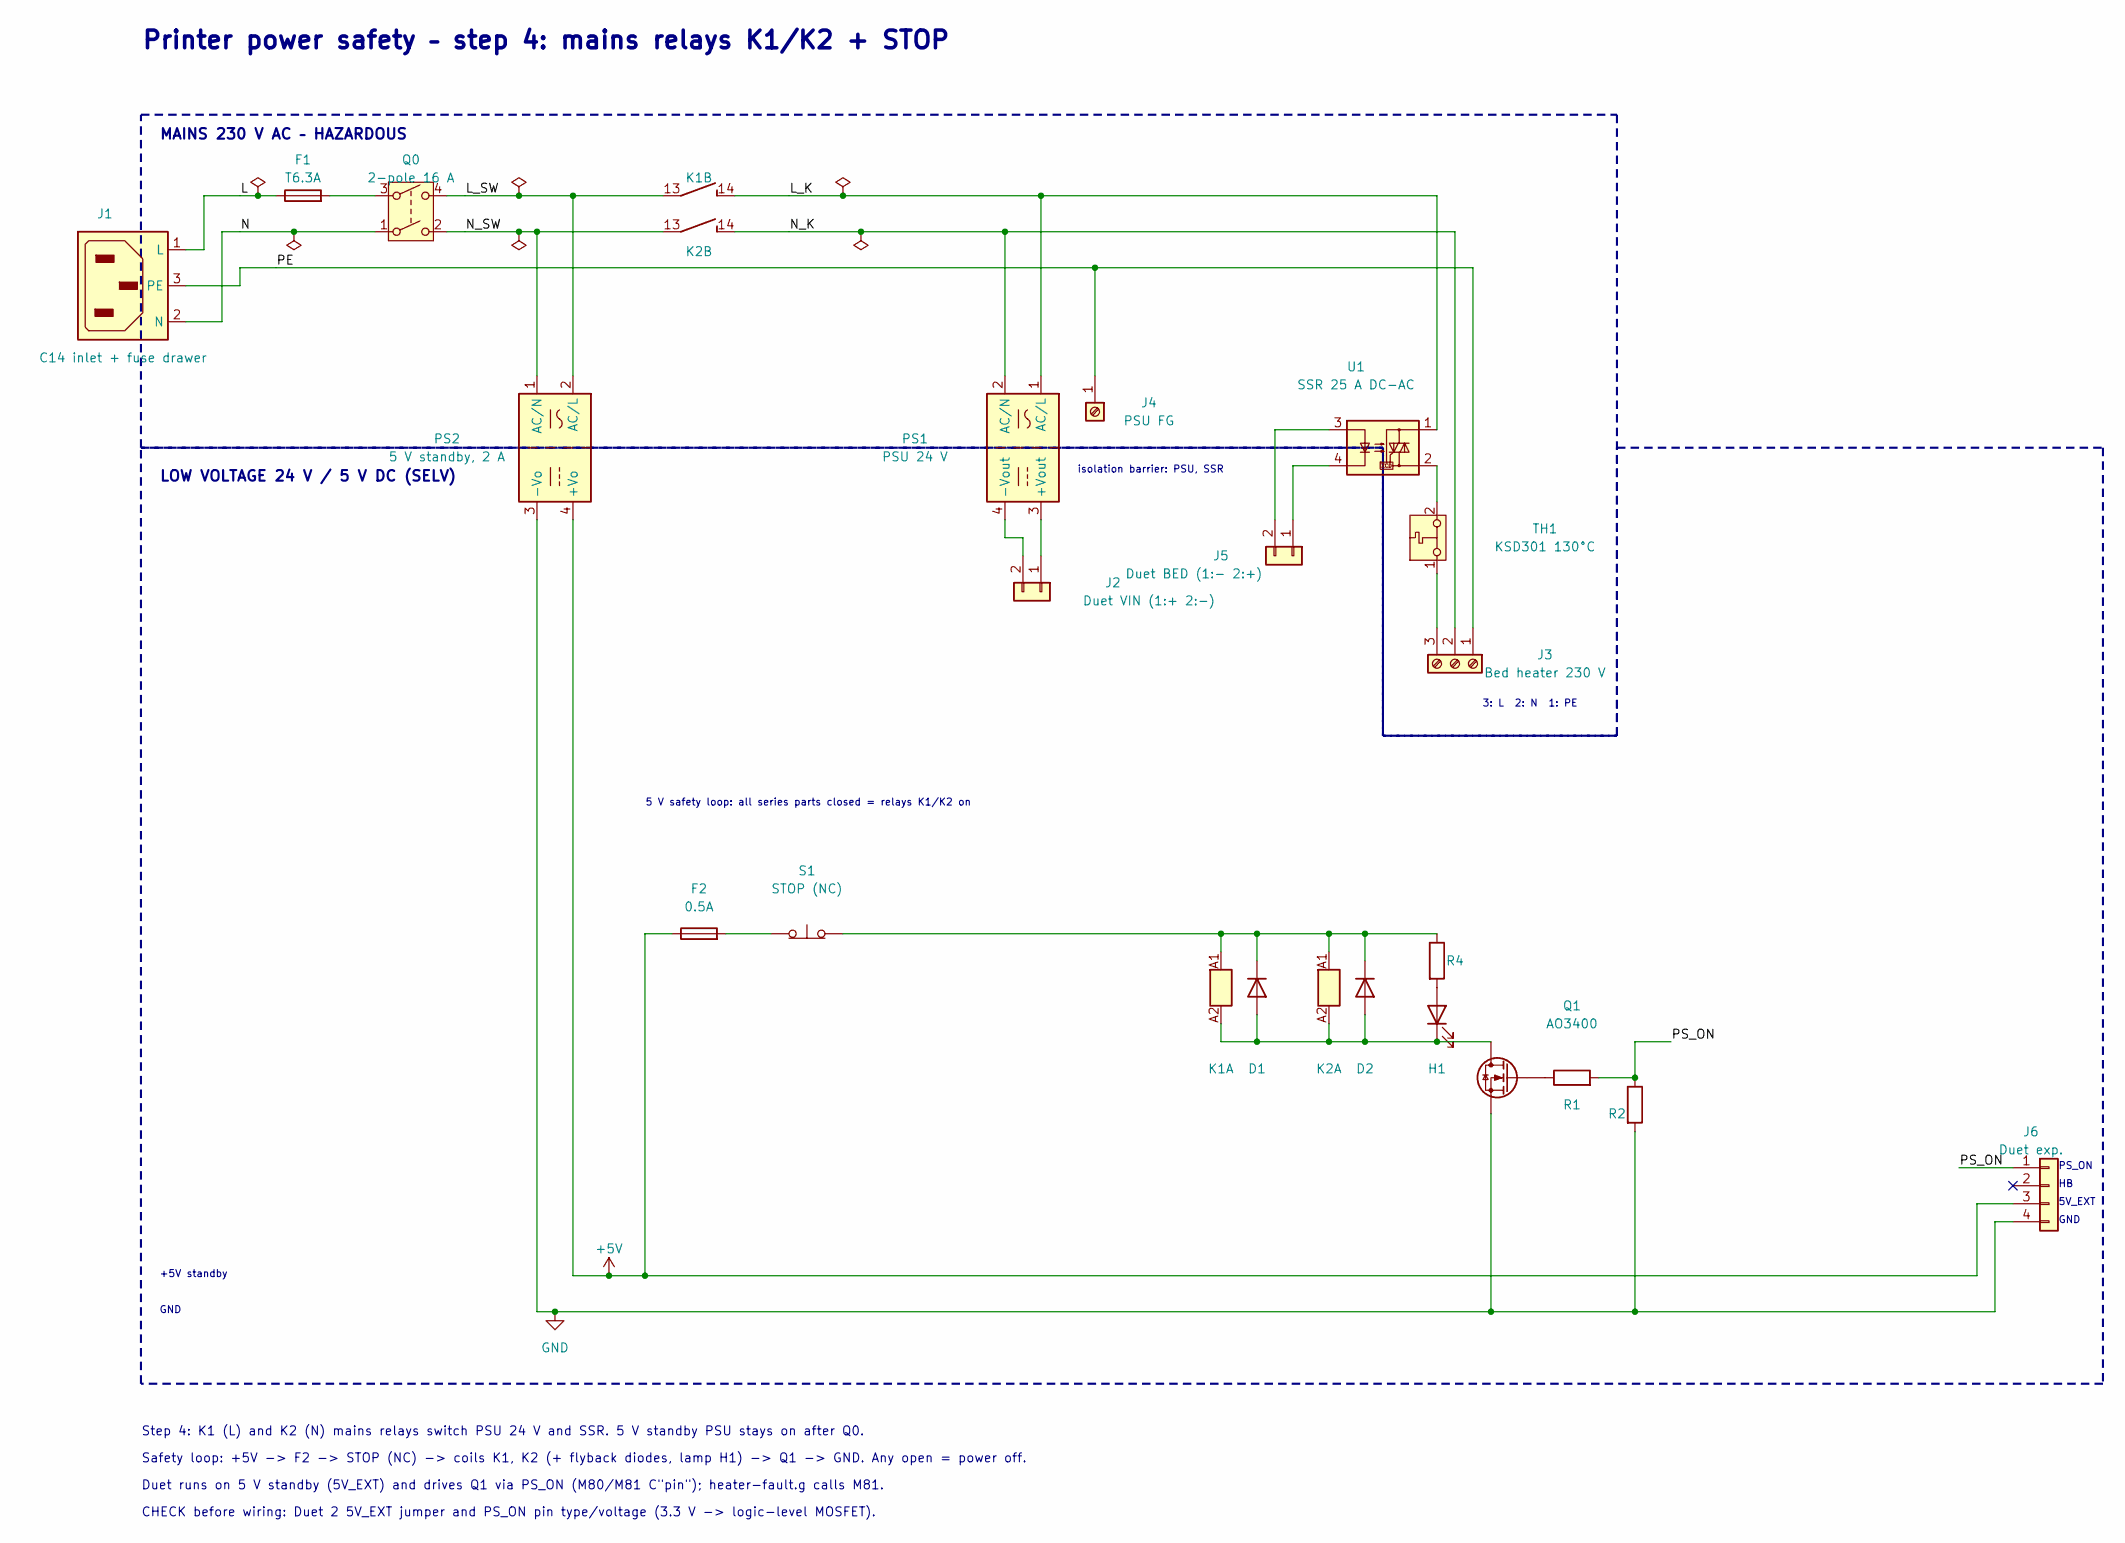
[picture p18: schematic step4_mains_relays_stop.kicad_sch]

Parts:
D1, D2: 1N4148
F1: T6.3A
F2: 0.5A
H1: LED
J1: C14 inlet + fuse drawer
J2: Duet VIN (1:+ 2:-)
J3: Bed heater 230 V
J4: PSU FG
J5: Duet BED (1:- 2:+)
J6: Duet exp.
K1, K2: G2RL-1A-E 5V 16A
PS1: PSU 24 V
PS2: 5 V standby, 2 A
Q0: 2-pole 16 A
Q1: AO3400
R1: 100
R2: 10k
R4: 330
S1: STOP (NC)
TH1: KSD301 130°C
U1: SSR 25 A DC-AC

Connections:
+5V: F2.1, J6.3, PS2.4 (+Vo)
GND: J6.4, PS2.3 (-Vo), Q1.S, R2.2
L: F1.1, J1.1 (L)
L_K: K1.14, PS1.1 (AC/L), U1.1
L_SW: K1.13, PS2.2 (AC/L), Q0.4
N: J1.2 (N), Q0.1
N_K: J3.2, K2.14, PS1.2 (AC/N)
N_SW: K2.13, PS2.1 (AC/N), Q0.2
unnamed: D1.1 (K), D2.1 (K), K1.A1, K2.A1, R4.1, S1.2 (B)
unnamed: D1.2 (A), D2.2 (A), H1.1 (K), K1.A2, K2.A2, Q1.D
unnamed: F1.2, Q0.3
unnamed: F2.2, S1.1 (A)
unnamed: H1.2 (A), R4.2
unnamed: J2.1, PS1.3 (+Vout)
unnamed: J2.2, PS1.4 (-Vout)
unnamed: J3.3, TH1.1
unnamed: J5.1, U1.4
unnamed: J5.2, U1.3
unnamed: Q1.G, R1.1
unnamed: TH1.2, U1.2
PE: J1.3 (PE), J3.1, J4.1
PS_ON: J6.1, R1.2, R2.1

Notes on the sheet:
3: L 2: N 1: PE
MAINS 230 V AC – HAZARDOUS
LOW VOLTAGE 24 V / 5 V DC (SELV)
isolation barrier: PSU, SSR
PS_ON
5V_EXT
GND
+5V standby
5 V safety loop: all series parts closed = relays K1/K2 on
Printer power safety – step 4: mains relays K1/K2 + STOP
Step 4: K1 (L) and K2 (N) mains relays switch PSU 24 V and SSR. 5 V standby PSU stays on after Q0.
Safety loop: +5V -> F2 -> STOP (NC) -> coils K1, K2 (+ flyback diodes, lamp H1) -> Q1 -> GND. Any open = power off.
Duet runs on 5 V standby (5V_EXT) and drives Q1 via PS_ON (M80/M81 C"pin"); heater-fault.g calls M81.
CHECK before wiring: Duet 2 5V_EXT jumper and PS_ON pin type/voltage (3.3 V -> logic-level MOSFET).
