grzechot/smokepowerlatch/kicad/steps/step6_smoke_detector.kicad_sch

## KiCad design kicad/steps/step6_smoke_detector.kicad_sch (2026-11-04)

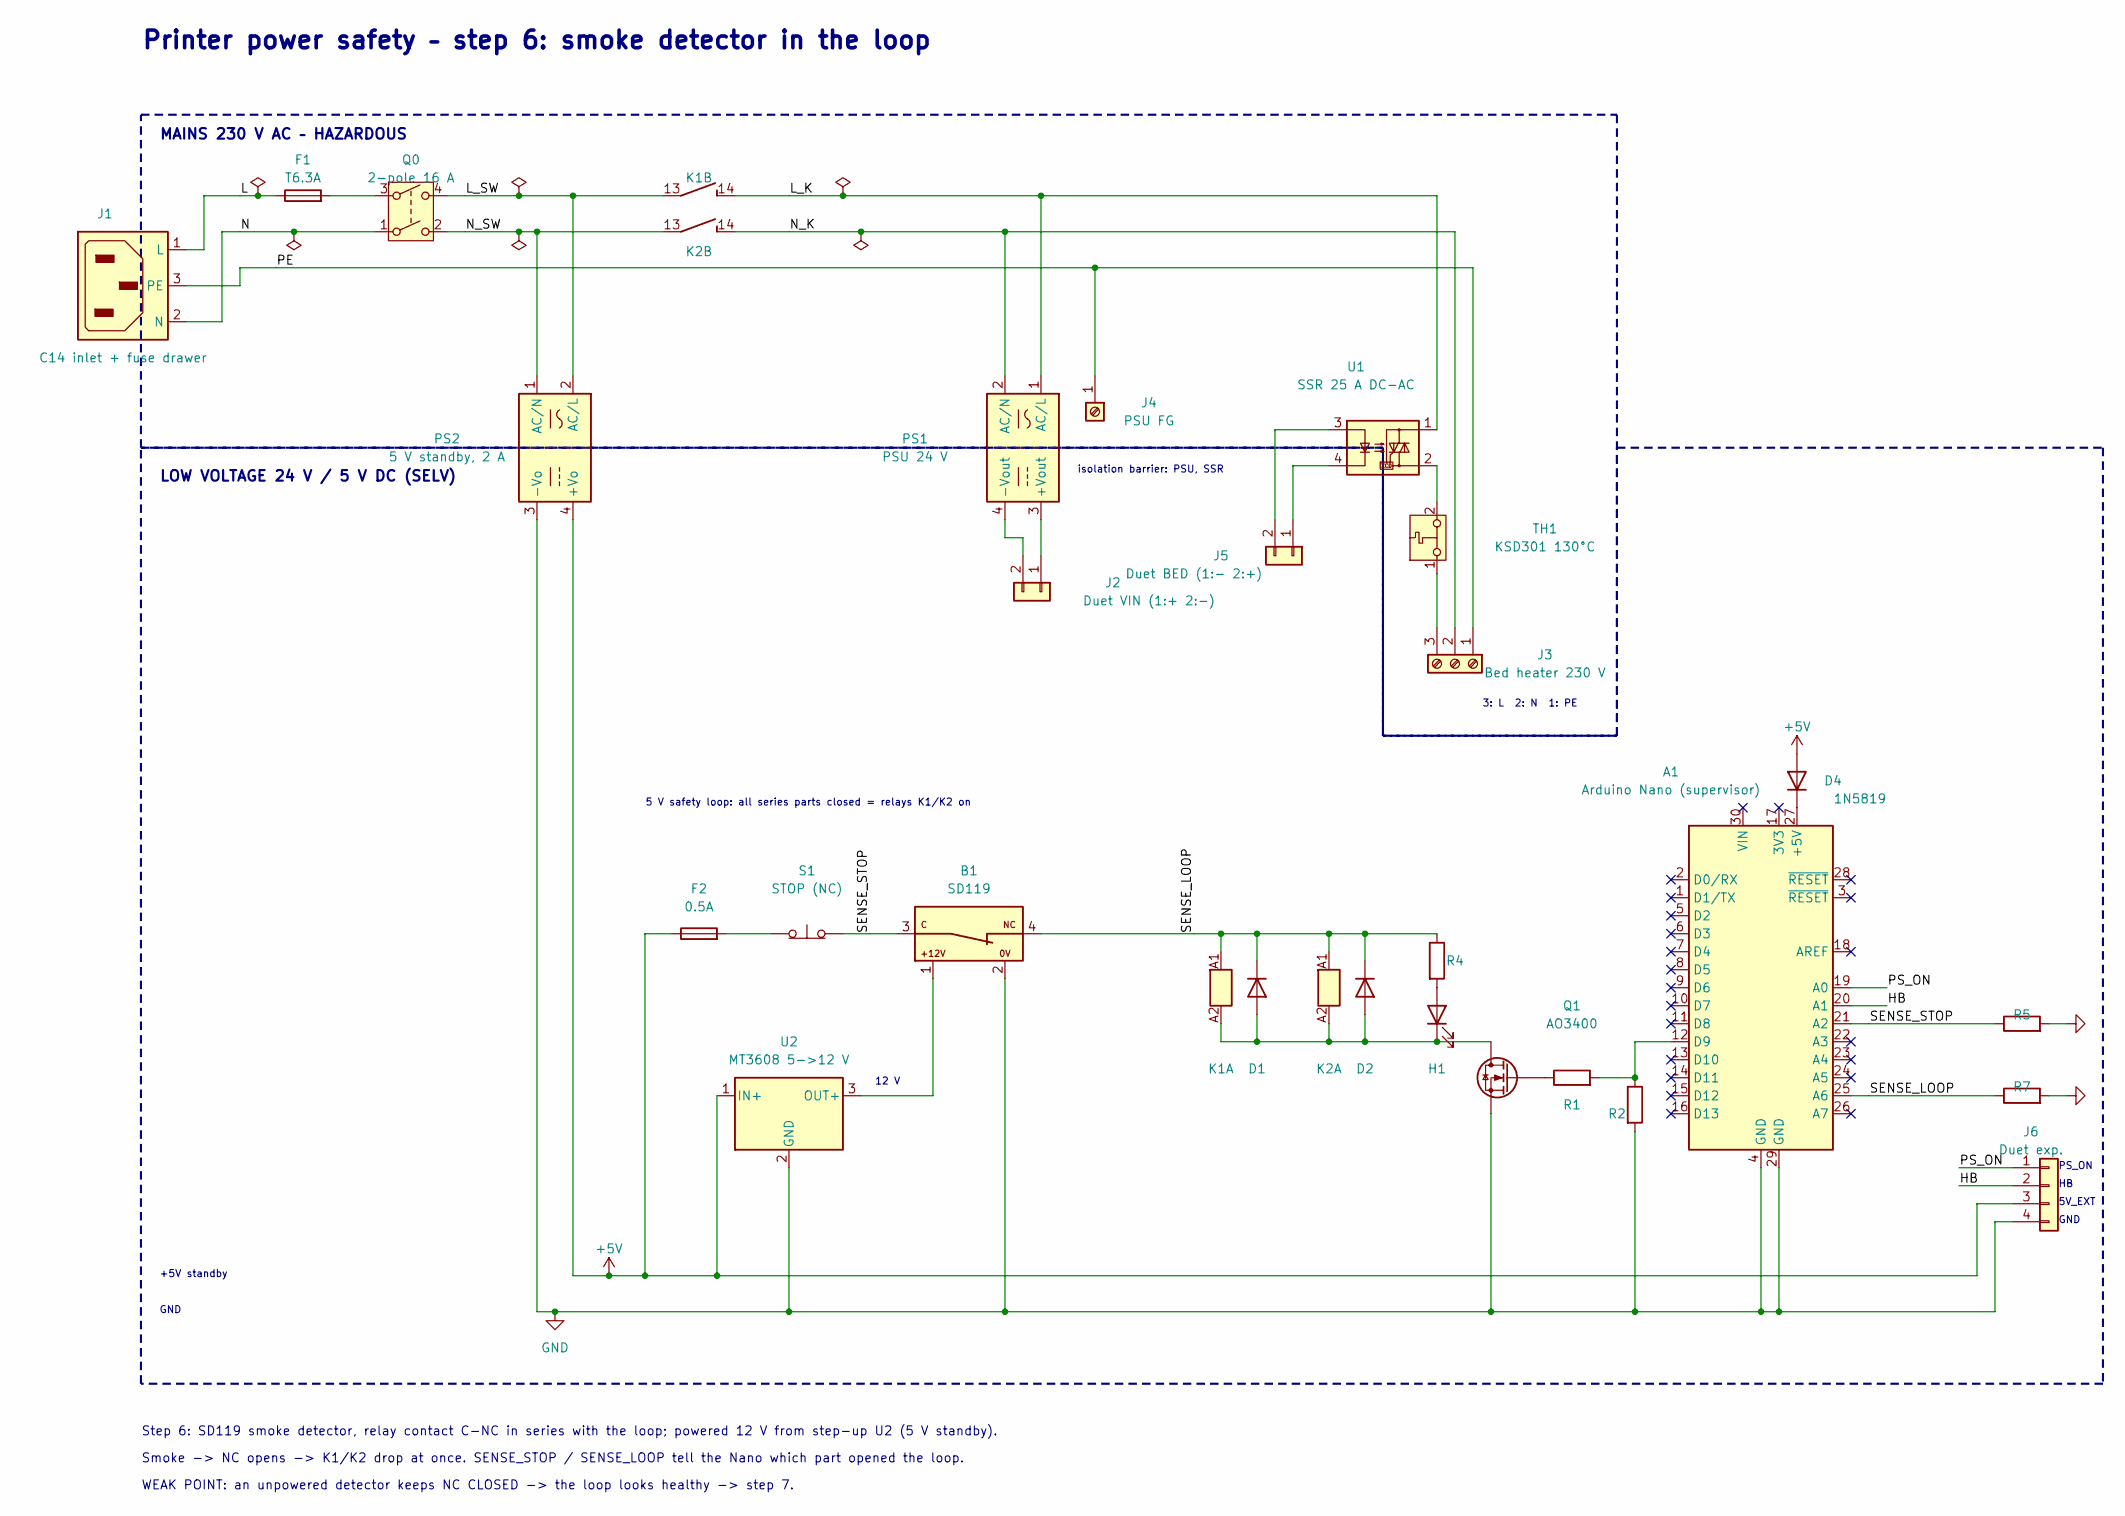
[picture p19: schematic step6_smoke_detector.kicad_sch]

Parts:
A1: Arduino Nano (supervisor)
B1: SD119
D1, D2: 1N4148
D4: 1N5819
F1: T6.3A
F2: 0.5A
H1: LED
J1: C14 inlet + fuse drawer
J2: Duet VIN (1:+ 2:-)
J3: Bed heater 230 V
J4: PSU FG
J5: Duet BED (1:- 2:+)
J6: Duet exp.
K1, K2: G2RL-1A-E 5V 16A
PS1: PSU 24 V
PS2: 5 V standby, 2 A
Q0: 2-pole 16 A
Q1: AO3400
R1: 100
R2, R5, R7: 10k
R4: 330
S1: STOP (NC)
TH1: KSD301 130°C
U1: SSR 25 A DC-AC
U2: MT3608 5->12 V

Connections:
+5V: D4.2 (A), F2.1, J6.3, PS2.4 (+Vo), U2.1 (IN+)
GND: A1.4 (GND), A1.29 (GND), B1.2 (0V), J6.4, PS2.3 (-Vo), Q1.S, R2.2, R5.2, R7.2, U2.2 (GND)
HB: A1.20 (A1), J6.2
L: F1.1, J1.1 (L)
L_K: K1.14, PS1.1 (AC/L), U1.1
L_SW: K1.13, PS2.2 (AC/L), Q0.4
N: J1.2 (N), Q0.1
N_K: J3.2, K2.14, PS1.2 (AC/N)
N_SW: K2.13, PS2.1 (AC/N), Q0.2
unnamed: A1.12 (D9), R1.2, R2.1
unnamed: A1.27 (+5V), D4.1 (K)
unnamed: B1.1 (+12V), U2.3 (OUT+)
unnamed: D1.2 (A), D2.2 (A), H1.1 (K), K1.A2, K2.A2, Q1.D
unnamed: F1.2, Q0.3
unnamed: F2.2, S1.1 (A)
unnamed: H1.2 (A), R4.2
unnamed: J2.1, PS1.3 (+Vout)
unnamed: J2.2, PS1.4 (-Vout)
unnamed: J3.3, TH1.1
unnamed: J5.1, U1.4
unnamed: J5.2, U1.3
unnamed: Q1.G, R1.1
unnamed: TH1.2, U1.2
PE: J1.3 (PE), J3.1, J4.1
PS_ON: A1.19 (A0), J6.1
SENSE_LOOP: A1.25 (A6), B1.4 (NC), D1.1 (K), D2.1 (K), K1.A1, K2.A1, R4.1, R7.1
SENSE_STOP: A1.21 (A2), B1.3 (C), R5.1, S1.2 (B)

Notes on the sheet:
3: L 2: N 1: PE
MAINS 230 V AC – HAZARDOUS
LOW VOLTAGE 24 V / 5 V DC (SELV)
isolation barrier: PSU, SSR
12 V
PS_ON
5V_EXT
GND
+5V standby
5 V safety loop: all series parts closed = relays K1/K2 on
Printer power safety – step 6: smoke detector in the loop
Step 6: SD119 smoke detector, relay contact C-NC in series with the loop; powered 12 V from step-up U2 (5 V standby).
Smoke -> NC opens -> K1/K2 drop at once. SENSE_STOP / SENSE_LOOP tell the Nano which part opened the loop.
WEAK POINT: an unpowered detector keeps NC CLOSED -> the loop looks healthy -> step 7.
