grzechot/smokepowerlatch/(commit log)

2026-11-04 Printer power safety: 8-step KiCad schematics, docs and BOM
    Ladder-style mains and 5 V harness, steps 0-7: baseline, bed thermal
    cutoff, mains fuse, 2-pole switch, K1/K2 relays with fail-safe loop and
    STOP, Nano supervisor, SD119 smoke detector, K3 detector supervision.
    Generator (tools/gen_power.py) writes schematics and docs; ERC clean.
    [printer_power_safety.kicad_sch, step0_baseline.kicad_sch, step1_bed_thermal_cutoff.kicad_sch, step2_mains_fuse.kicad_sch, step3_two_pole_switch.kicad_sch, step4_mains_relays_stop.kicad_sch, step5_supervisor.kicad_sch, step6_smoke_detector.kicad_sch]
2026-11-04 Reorder into core + extensions; add START self-hold
    Core A0-A4 protects against the worst faults with simple hardware:
    bed thermal cutoff, mains fuse, mains relays with STOP and START
    self-hold (no automatic restart), smoke detector with supply
    supervision relay K3. Extensions on A4: B1 Nano supervisor
    (watchdog + four sense nodes), C1 2-pole main switch. FULL = all.
    Hazard table in docs/steps.md; BOM for core and full.
    [A0_baseline.kicad_sch, A1_bed_thermal_cutoff.kicad_sch, A2_mains_fuse.kicad_sch, A3_mains_relays_stop.kicad_sch, A4_smoke_detector.kicad_sch, B1_supervisor.kicad_sch, C1_two_pole_switch.kicad_sch, FULL_full.kicad_sch]
2026-11-05 Stage sketches A0-A6 and stage descriptions
    New stage naming (Firestarter ... Paranoid), wiring-oriented sketches
    as SVG generated by tools/sketches.py, detector module with a 3-wire
    bundle (5 V, 0 V, OK) and supply supervision K3, effectiveness table
    and stage descriptions in docs/stages.md. README points to the stages.
2026-11-05 KiCad schematics regenerated for stages A0-A6
    Layout and wiring follow the stage sketches: mains rails at the bottom,
    low voltage above, detector module high with the 5V/0V/OK bundle,
    wire colours as bought. New symbols: Duet 2 block, 2-pole bed plug,
    4-pin step-up (IN-/OUT-), smoke detector with supply pins on top.
    [A0_baseline.kicad_sch, A0_firestarter.kicad_sch, A1_24_thermalcut.kicad_sch, A1_bed_thermal_cutoff.kicad_sch, A2_24_thermalcut_fuse.kicad_sch, A2_mains_fuse.kicad_sch, A3_24_relay.kicad_sch, A3_mains_relays_stop.kicad_sch]
2026-11-05 Detector module drawn top-down (Gregor's A5 layout) in the generator
    U2, SD119 and K3 stacked in the chain order; OK runs straight down to the
    K1 coil next to PS2. PS2 moved left, 5 V jogs to 5V_EXT, K1 coil and Q1
    re-placed. Fixes the short and broken L/N rails of the hand-edited A5.
    [A0_firestarter.kicad_sch, A1_24_thermalcut.kicad_sch, A2_24_thermalcut_fuse.kicad_sch, A3_24_relay.kicad_sch, A4_24-5.kicad_sch, A5_24-5_smoke.kicad_sch, A6_24-5_smoke_nano.kicad_sch, printer_power_safety.kicad_sch]
2026-11-05 Gregor's A5 placement in the generator: PS2 straight to the Duet, module and K1 moved right
    PS2 back under Duet GND / 5V_EXT (no jog), detector module, K1 and Q1/R1/R2
    shifted 13.97 mm right. Netlists unchanged; A5 matches the hand-edited file.
    [A0_firestarter.kicad_sch, A1_24_thermalcut.kicad_sch, A2_24_thermalcut_fuse.kicad_sch, A3_24_relay.kicad_sch, A4_24-5.kicad_sch, A5_24-5_smoke.kicad_sch, A6_24-5_smoke_nano.kicad_sch, printer_power_safety.kicad_sch]
2026-11-05 Add draft enclosure: 230 V mains module v4 (work in progress)
    STL, STEP, OpenSCAD and FreeCAD export script; previews without the
    third-party PowerSwitch-SSR-Mount enclosure, which is not included.
    READMEs mark the enclosures as drafts that will change, with more to come.
    [body_print.stl, cap_print.stl, modul_230V.scad, modul_korpus.step, modul_pokrywa.step]
2026-11-06 SmokePowerLatch: recommended A5 first, SW1 / K1+K2 notes, licences
    - README starts with the recommended build (A5 24/5+Smoke), then links to the stages
    A0-A7 as the evolution of the idea; README_PL.md added.
    - docs/stages.md: why SW1 should be 2-pole (reversible plugs), and why K1+K2 on two
    independent relays rather than one 2-pole relay (a welded contact); A7 updated.
    - Licences: CERN-OHL-P-2.0 for hardware and docs, MIT for scripts.
    - STEP headers: FreeCAD author set to Gregor.
    [modul_korpus.step, modul_pokrywa.step]
